0x72D0/MASA/Hardware/Kicad_Project/MASA_Rover_1.0/MASA_Rover_1.0.pdf

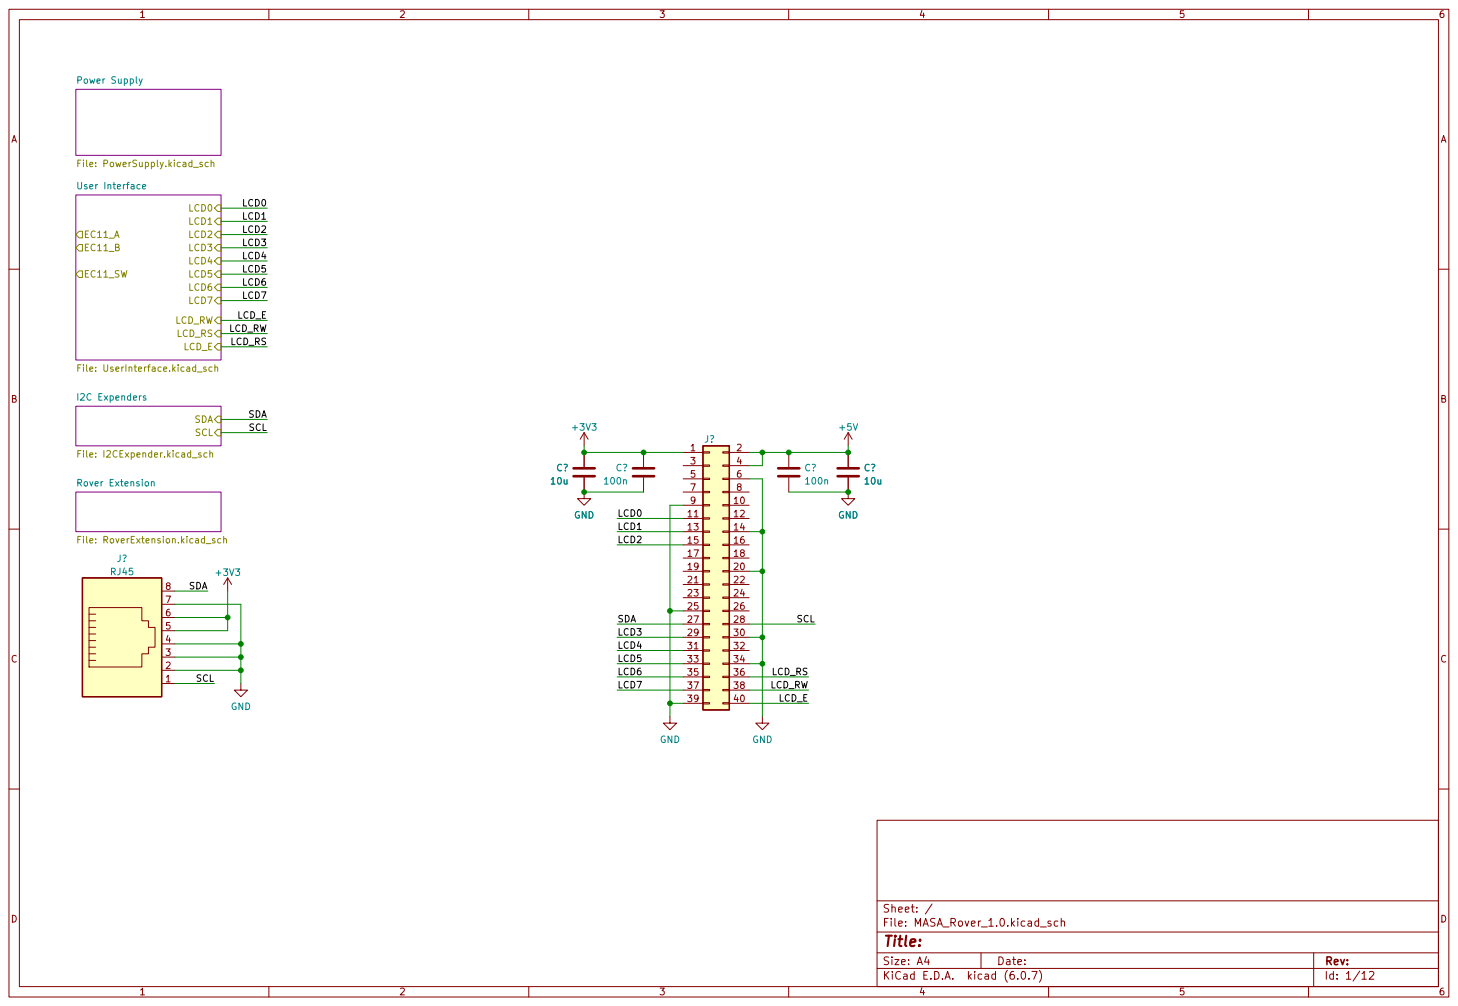
[picture p1: page 1]

User Interface File: UserInterface.kicad_sch Power Supply
File: PowerSupply.kicad_sch Rover Extension File: RoverExtension.kicad_sch SCL SDA

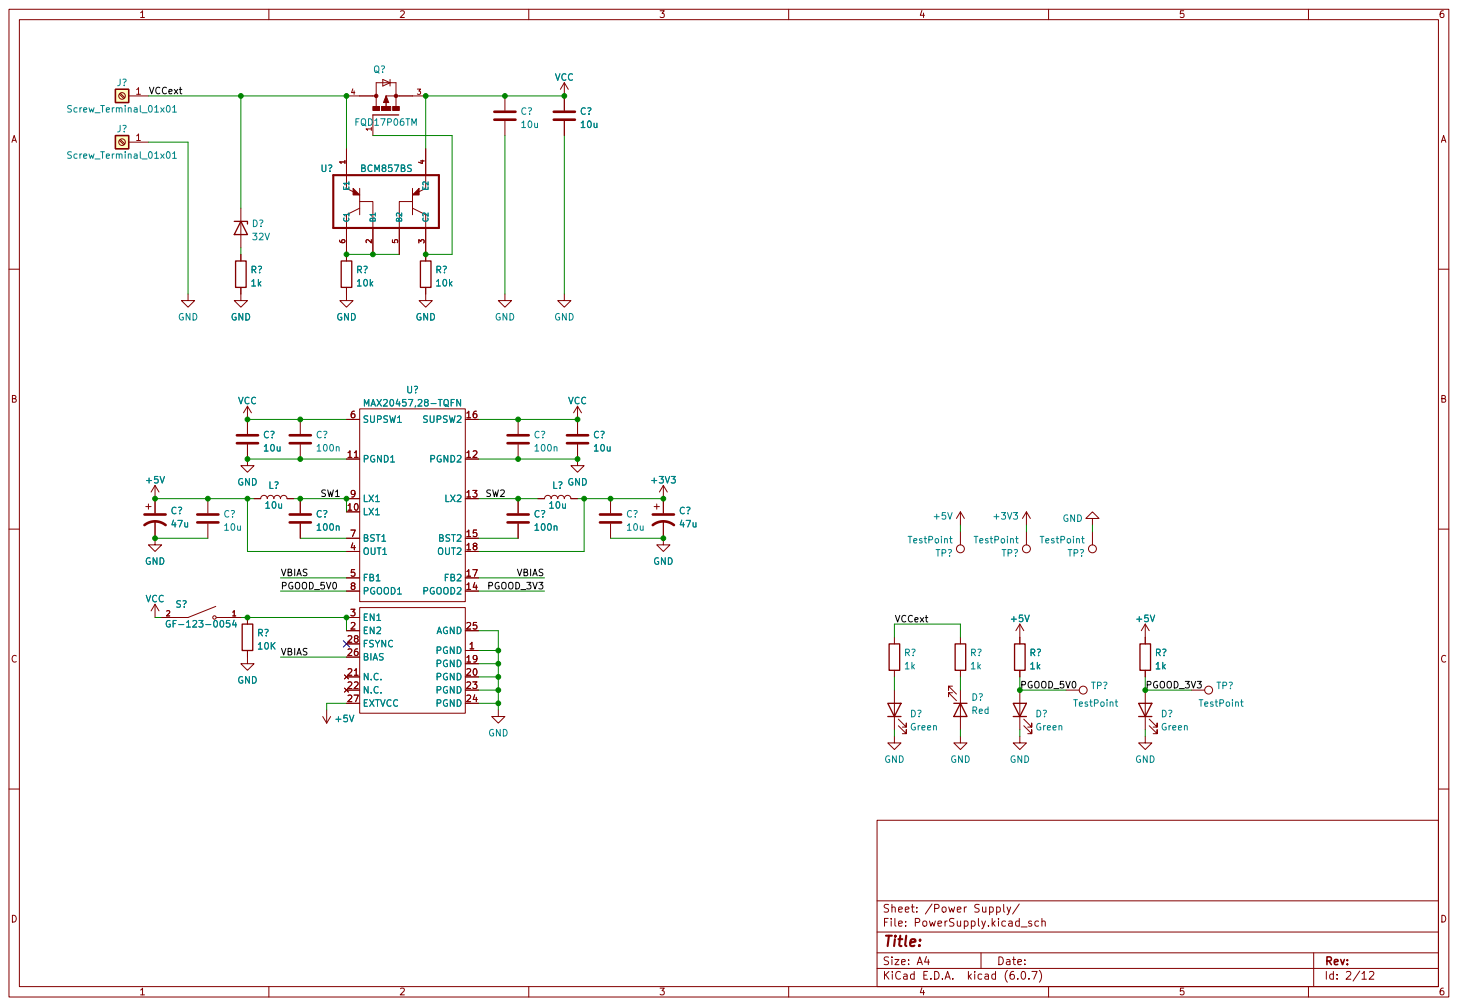
[picture p2: page 2]

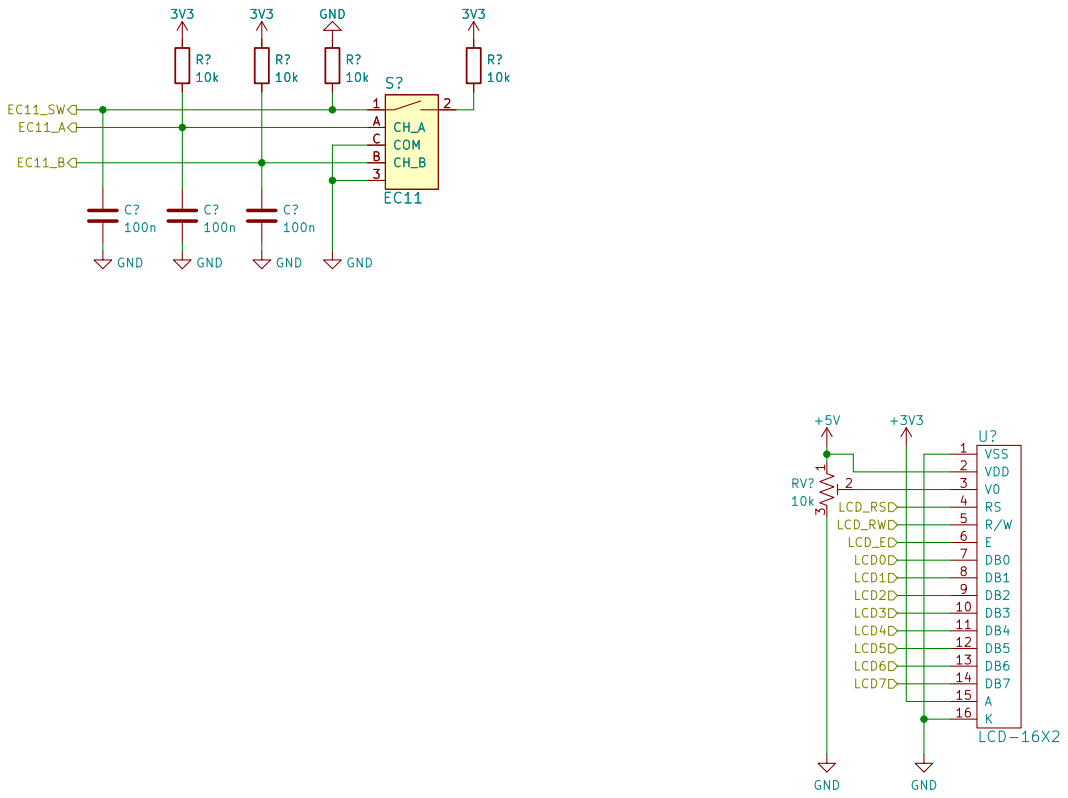
[picture p3: page 3]

File: UserInterface.kicad_sch Sheet: /User Interface/
Id: 3/12 Title:

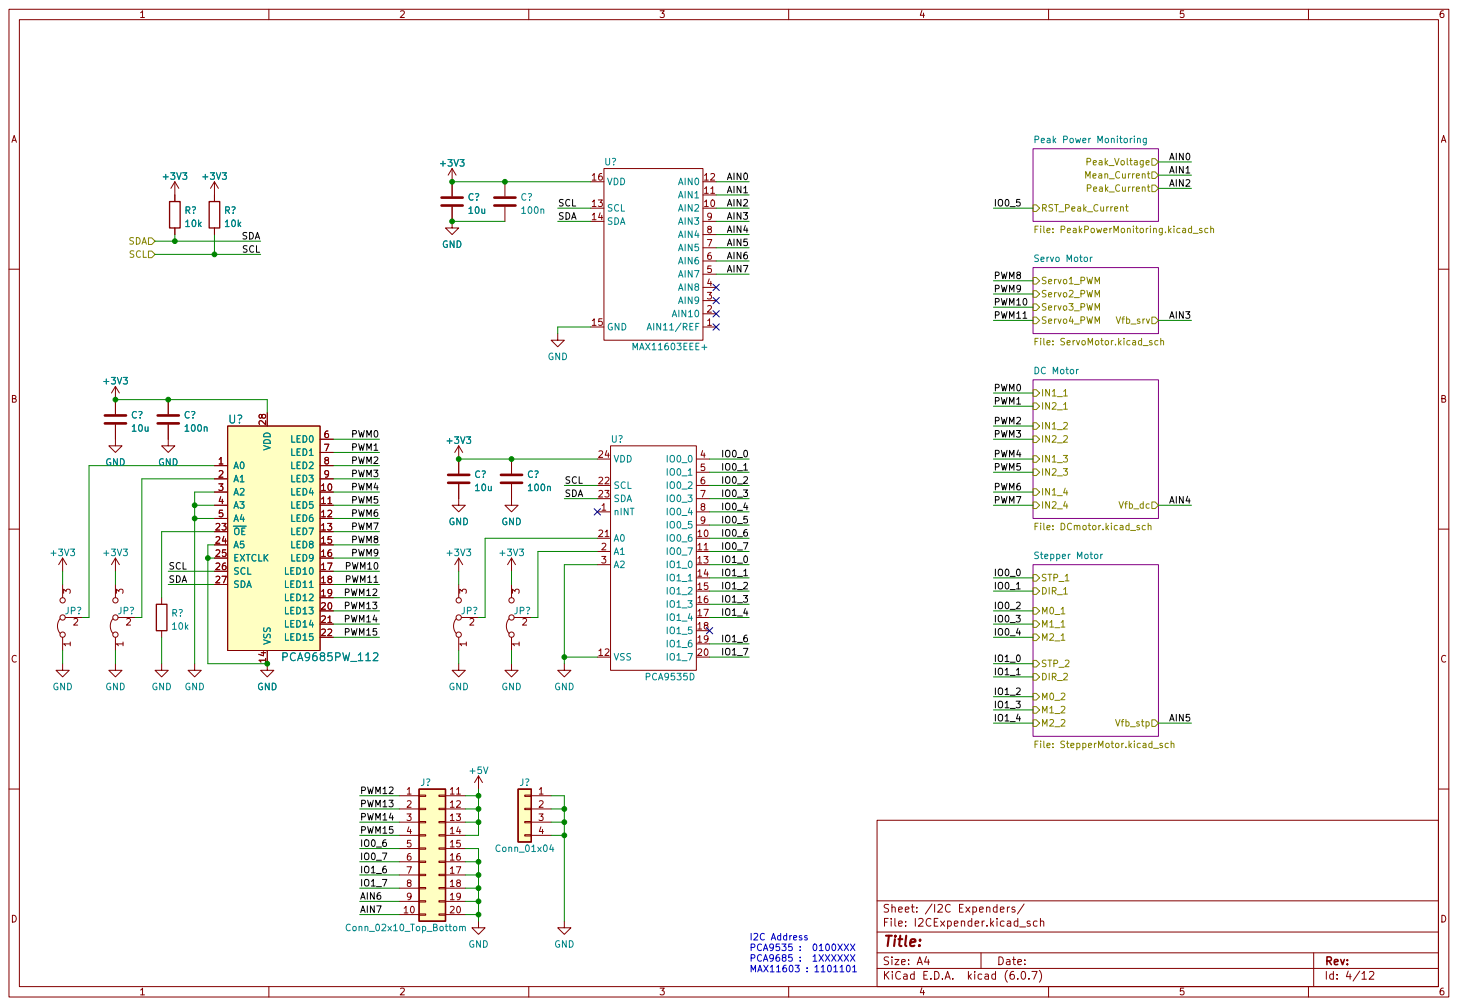
[picture p4: page 4]

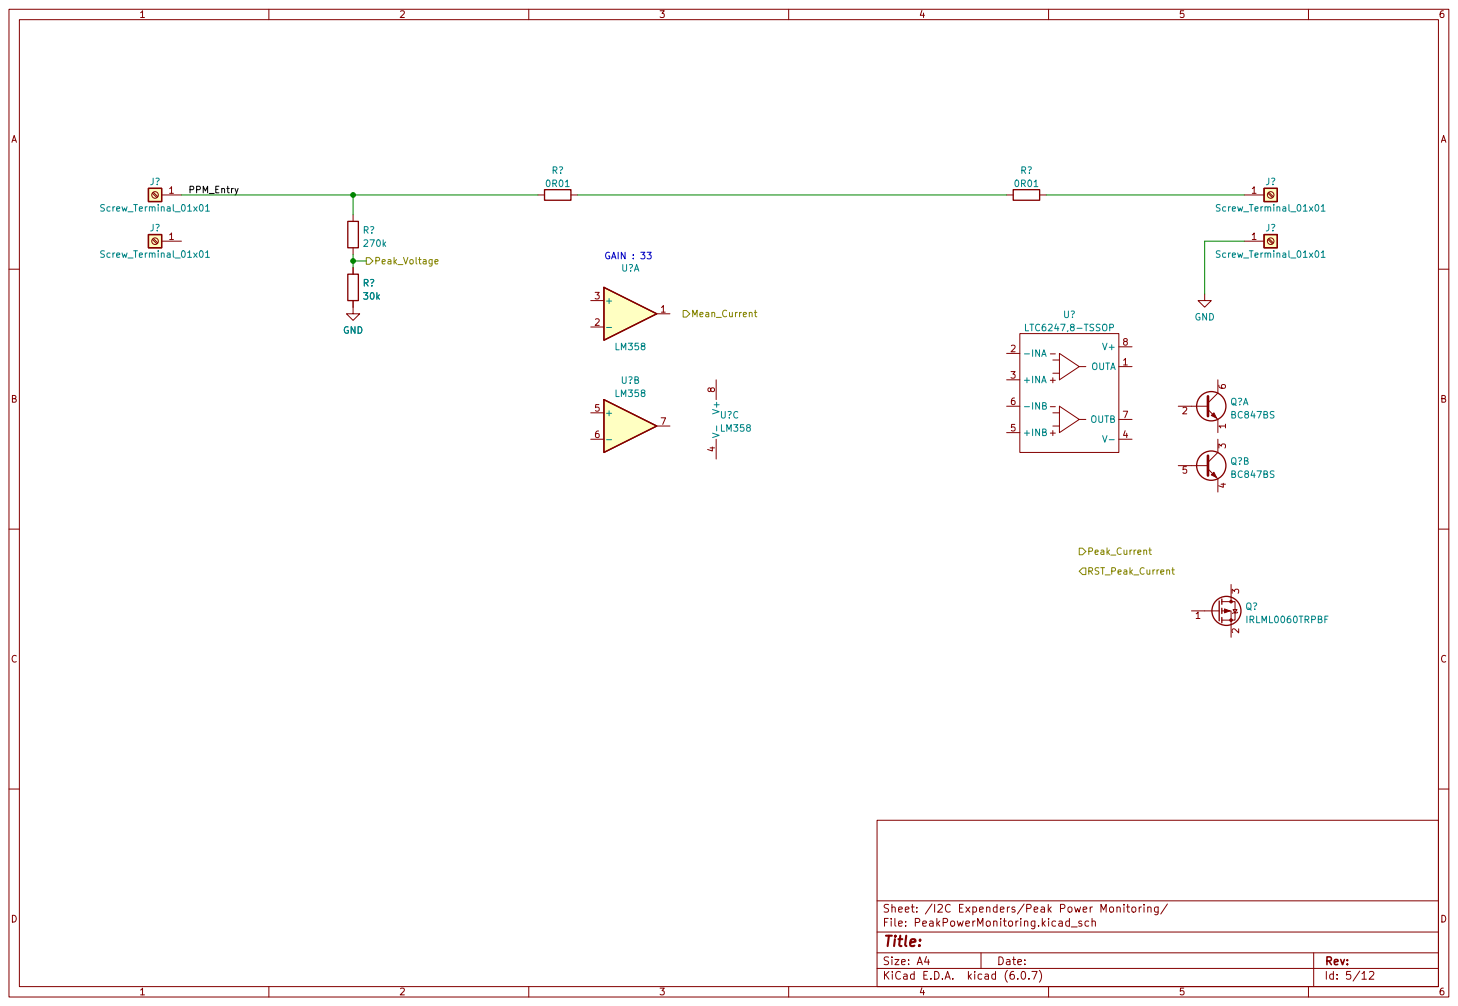
[picture p5: page 5]

Sheet: /I2C Expenders/Peak Power Monitoring/
File: PeakPowerMonitoring.kicad_sch
Id: 5/12 Title:

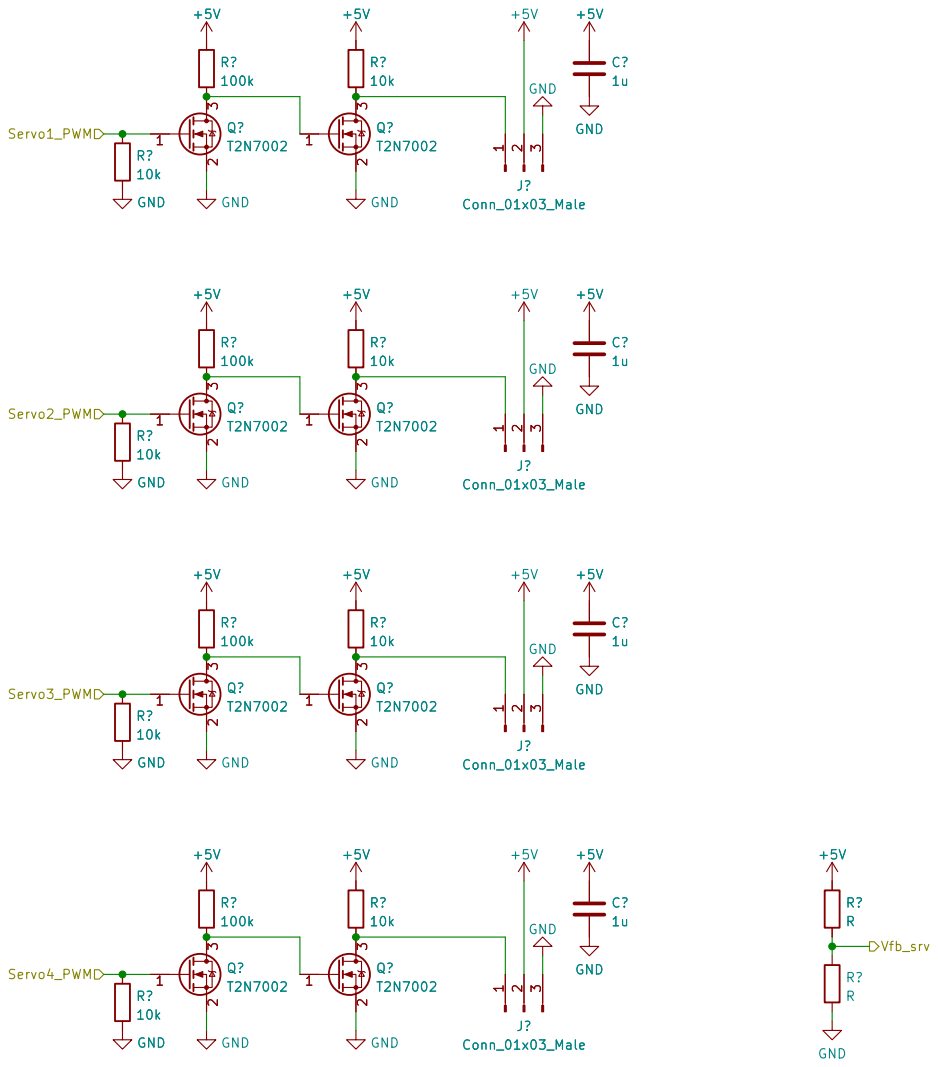
[picture p6: page 6]

Sheet: /I2C Expenders/Servo Motor/ +5V GND

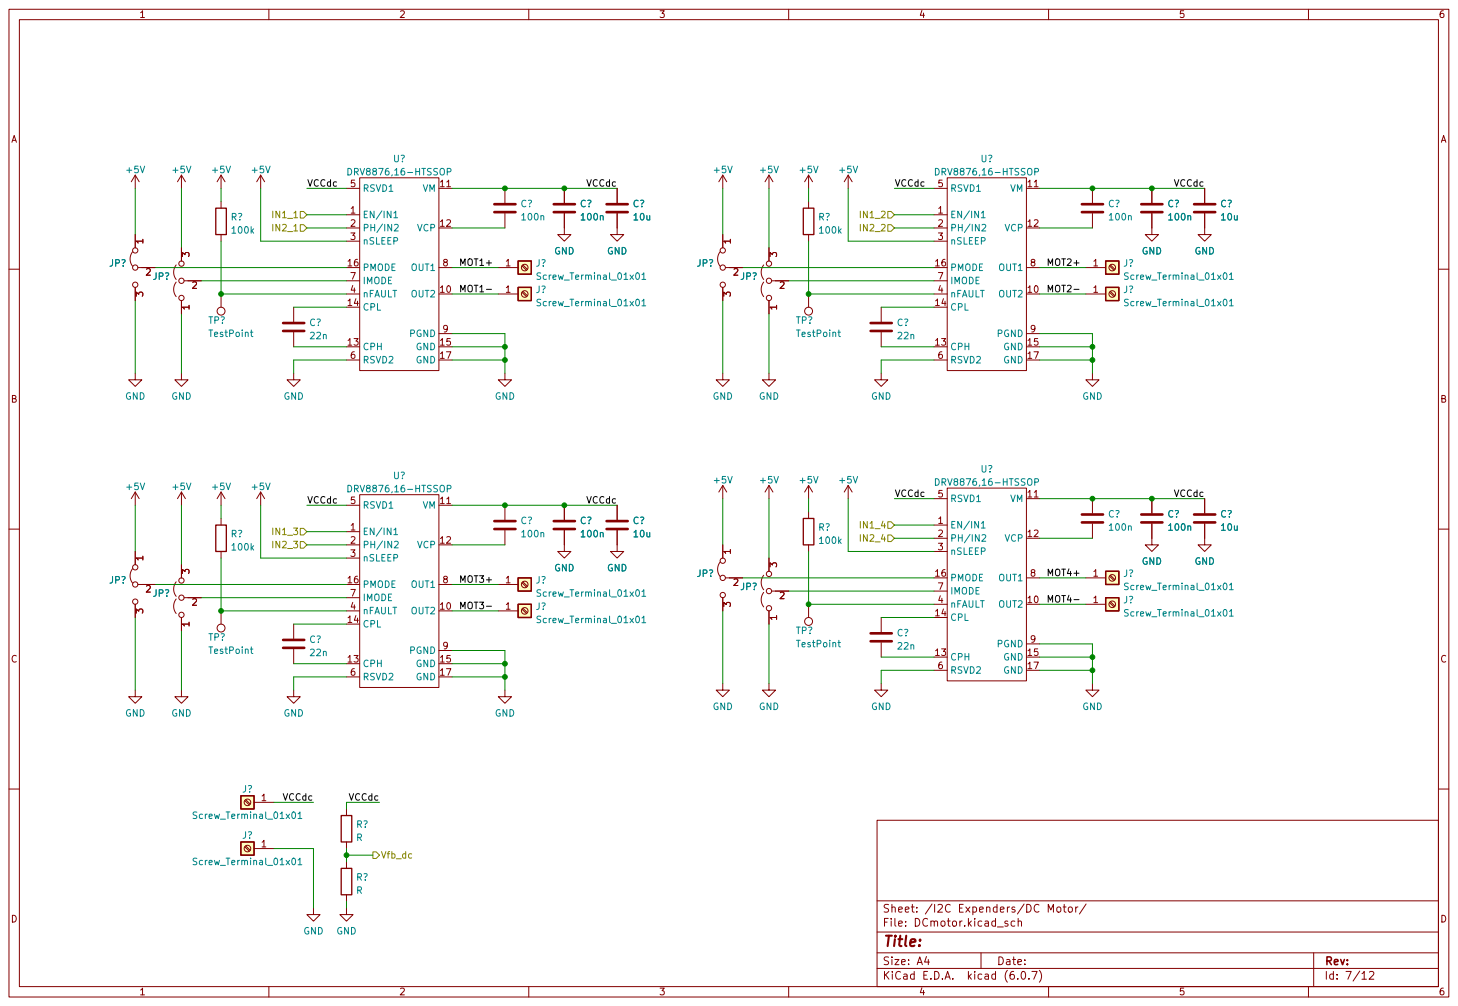
[picture p7: page 7]

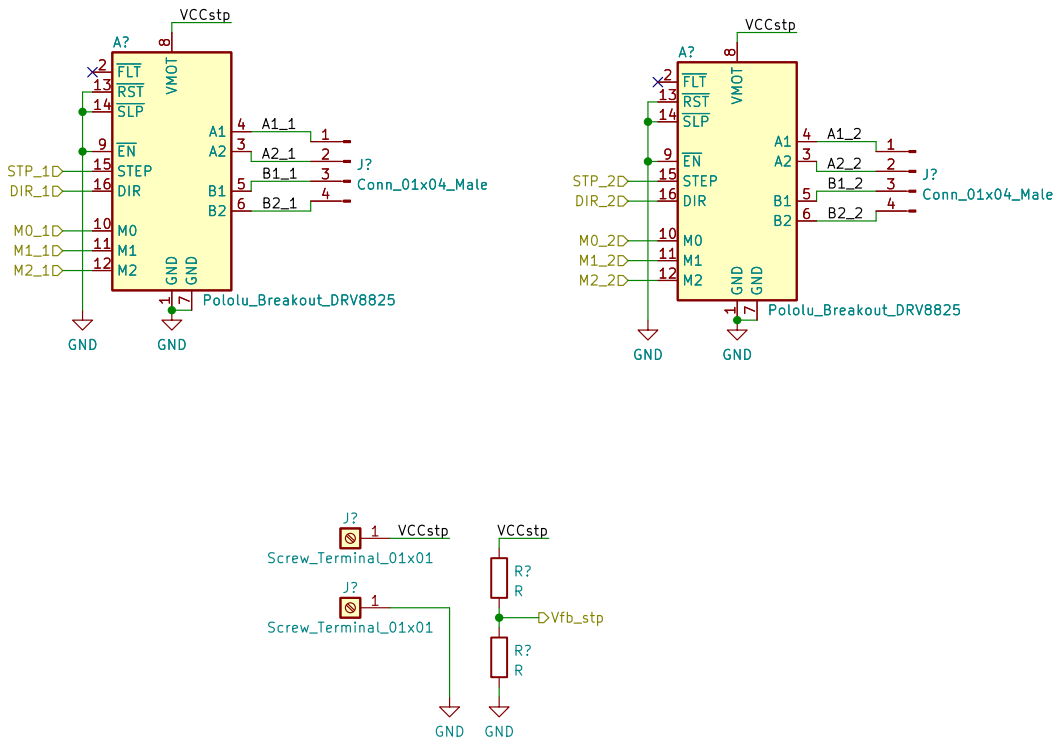
[picture p8: page 8]

8 ~{EN} 9 A? Pololu_Breakout_DRV8825 R? R GND GND GND GND

1 M0 10 M1 11 M2 12 ~{RST} 13 ~{SLP} 14 STEP 15 DIR 16 ~{FLT} 2 A2 3 A1 4 B1 5 B2 6 GND

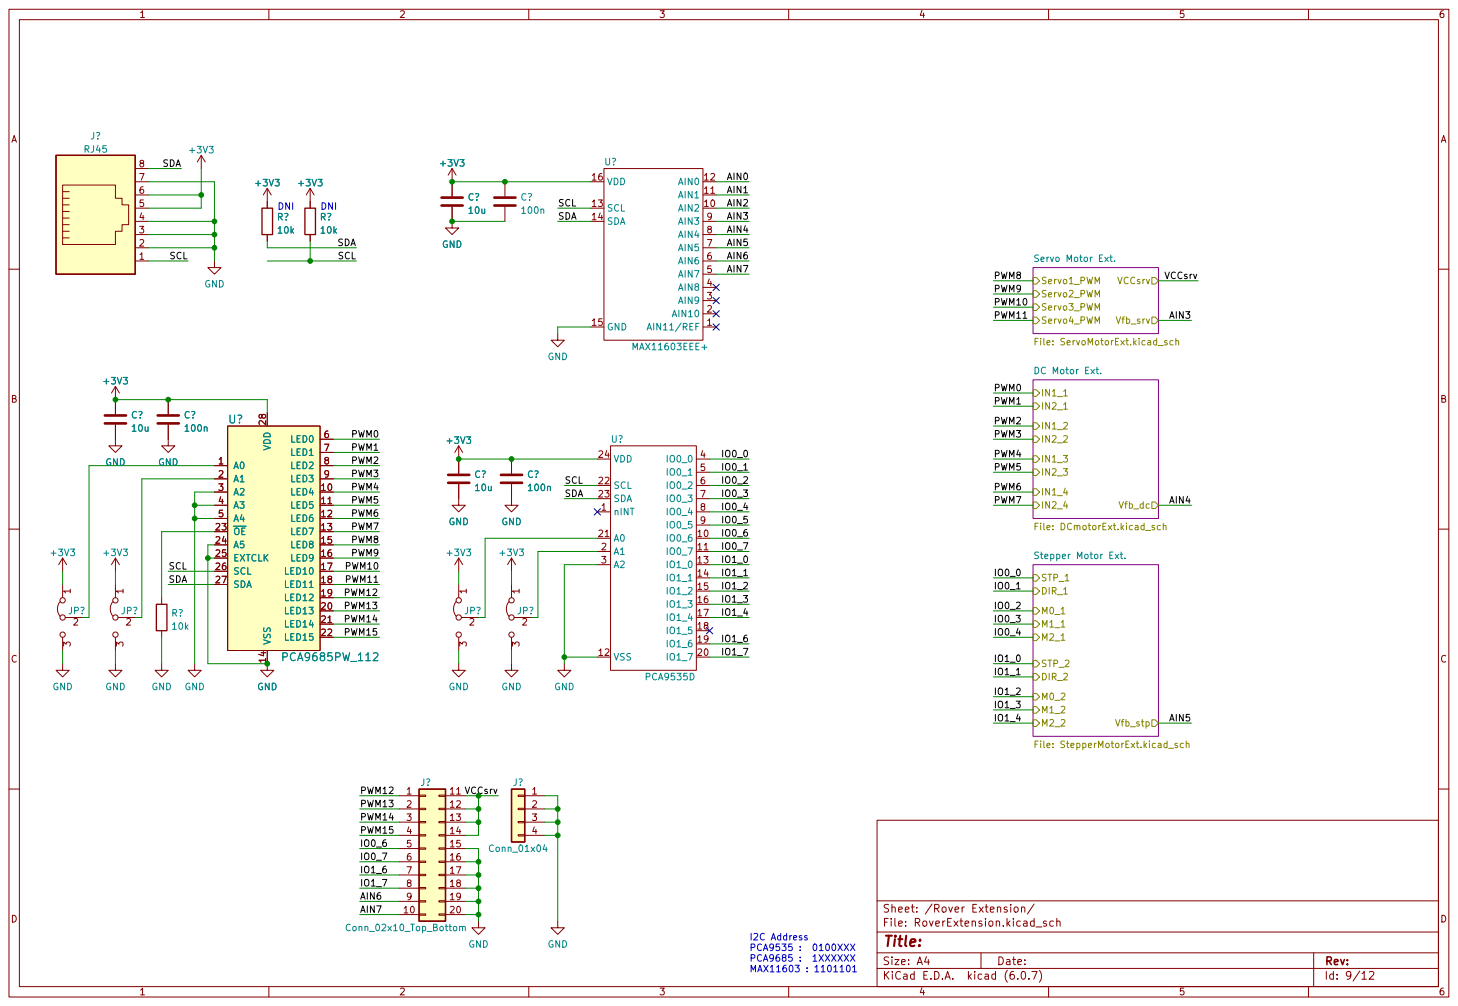
[picture p9: page 9]

3 JP? GND GND GND GND

File: RoverExtension.kicad_sch Sheet: /Rover Extension/
Id: 9/12 Title:

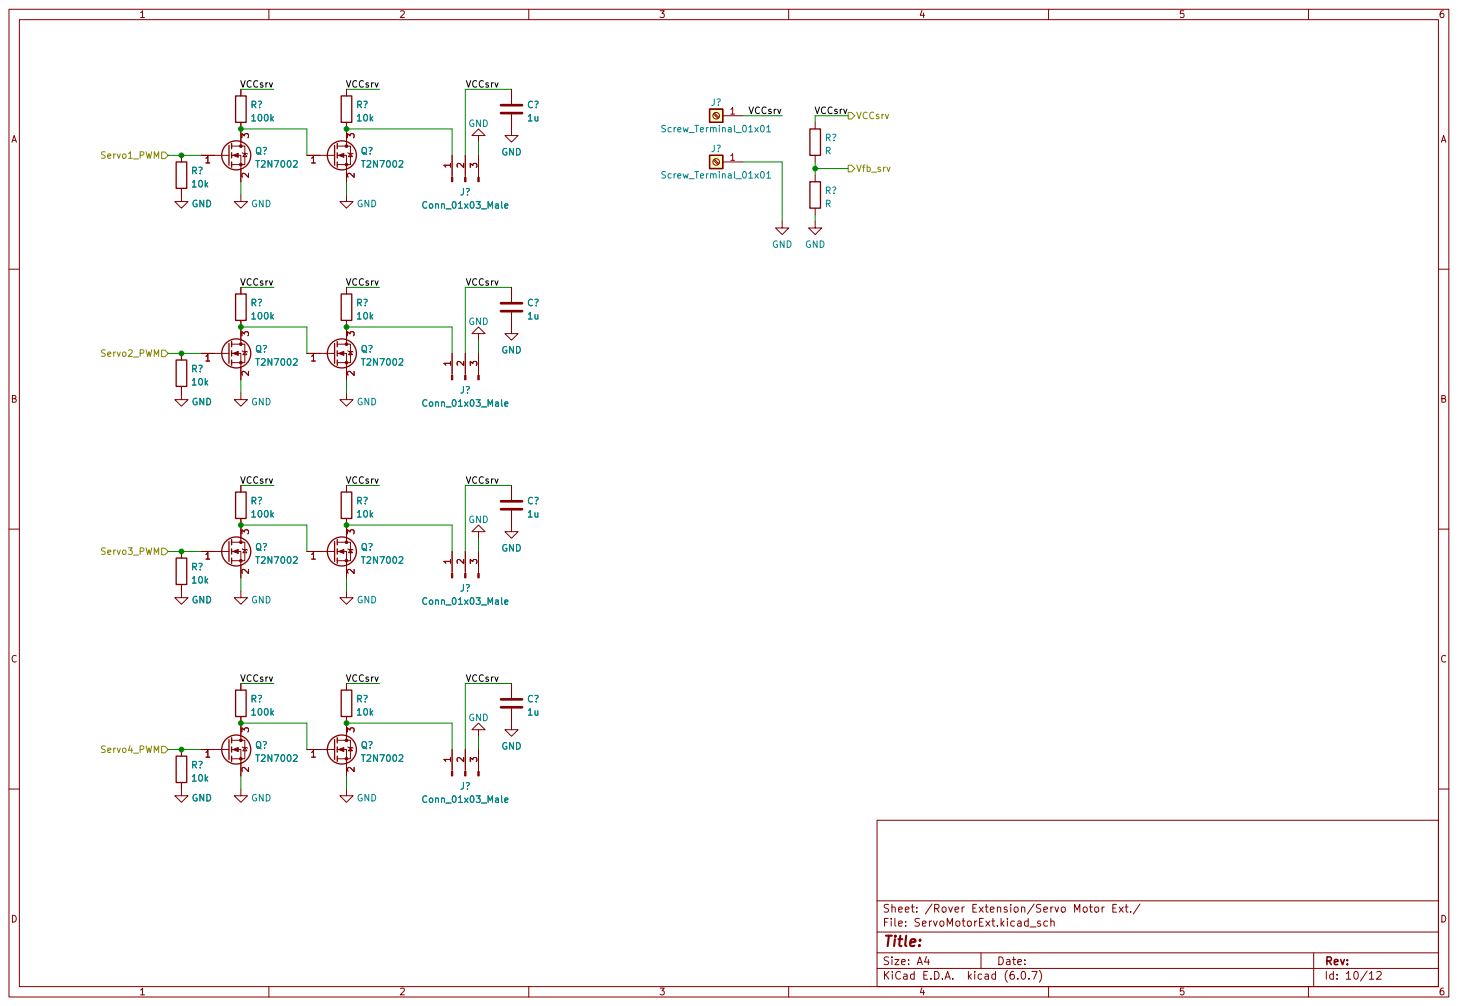
[picture p10: page 10]

File: ServoMotorExt.kicad_sch Sheet: /Rover Extension/Servo Motor Ext./
Id: 10/12 Title:

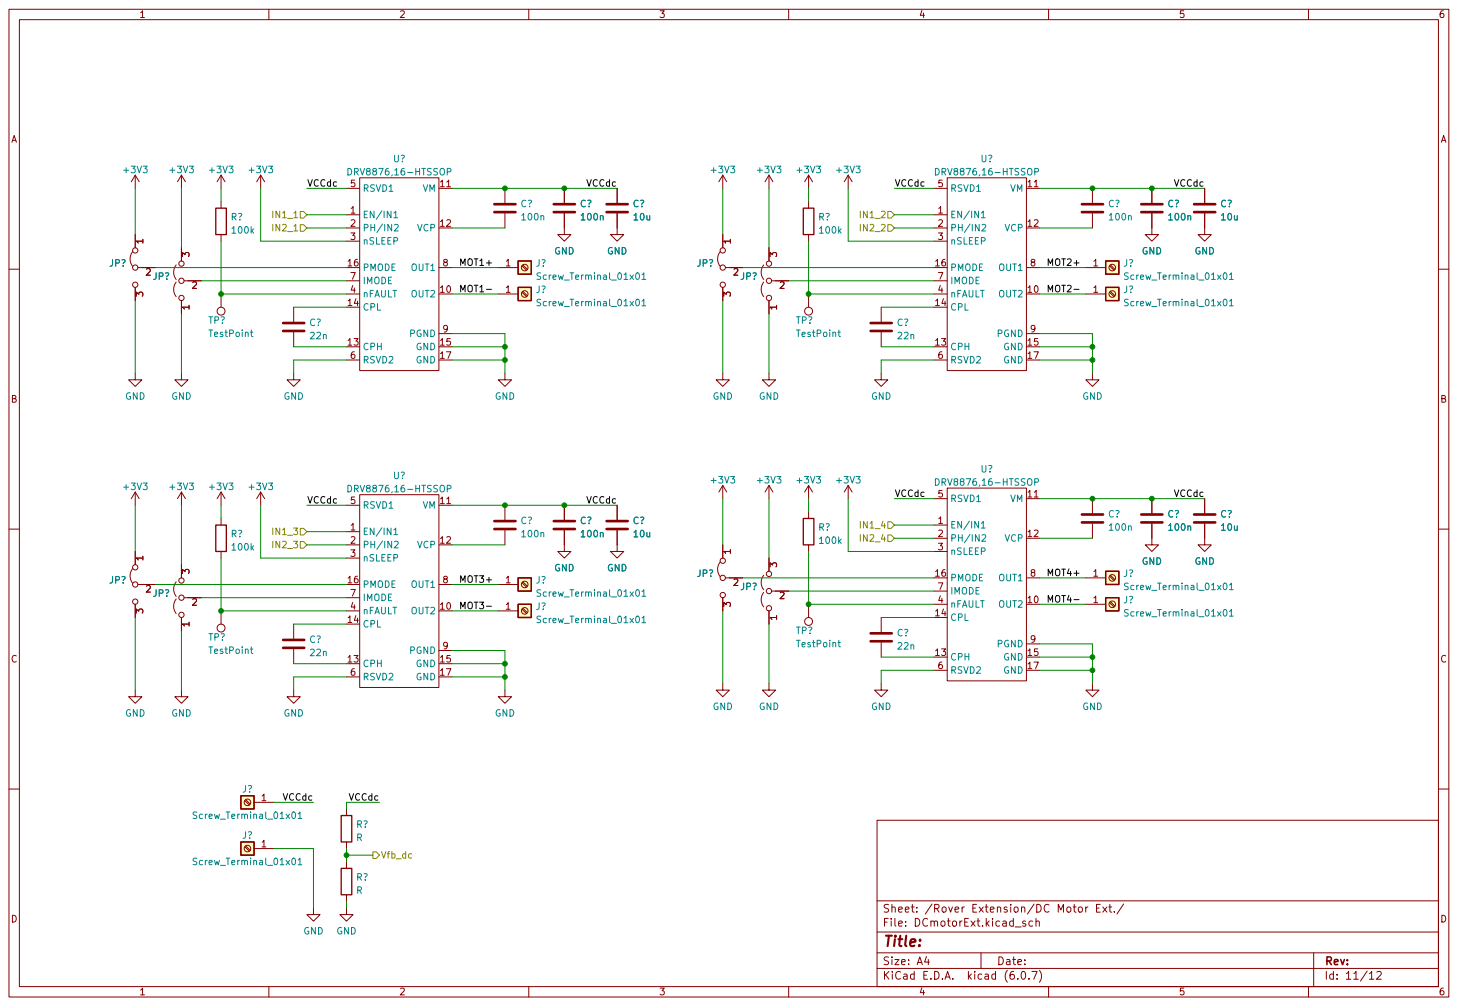
[picture p11: page 11]
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
