0x72D0/MASA/Hardware/Kicad_Project/MASA_Rover_1.0/MASA_Rover_1.0.kicad_pcb

## KiCad design Hardware/Kicad_Project/MASA_Rover_1.0/MASA_Rover_1.0.kicad_pcb (2022-11-12)

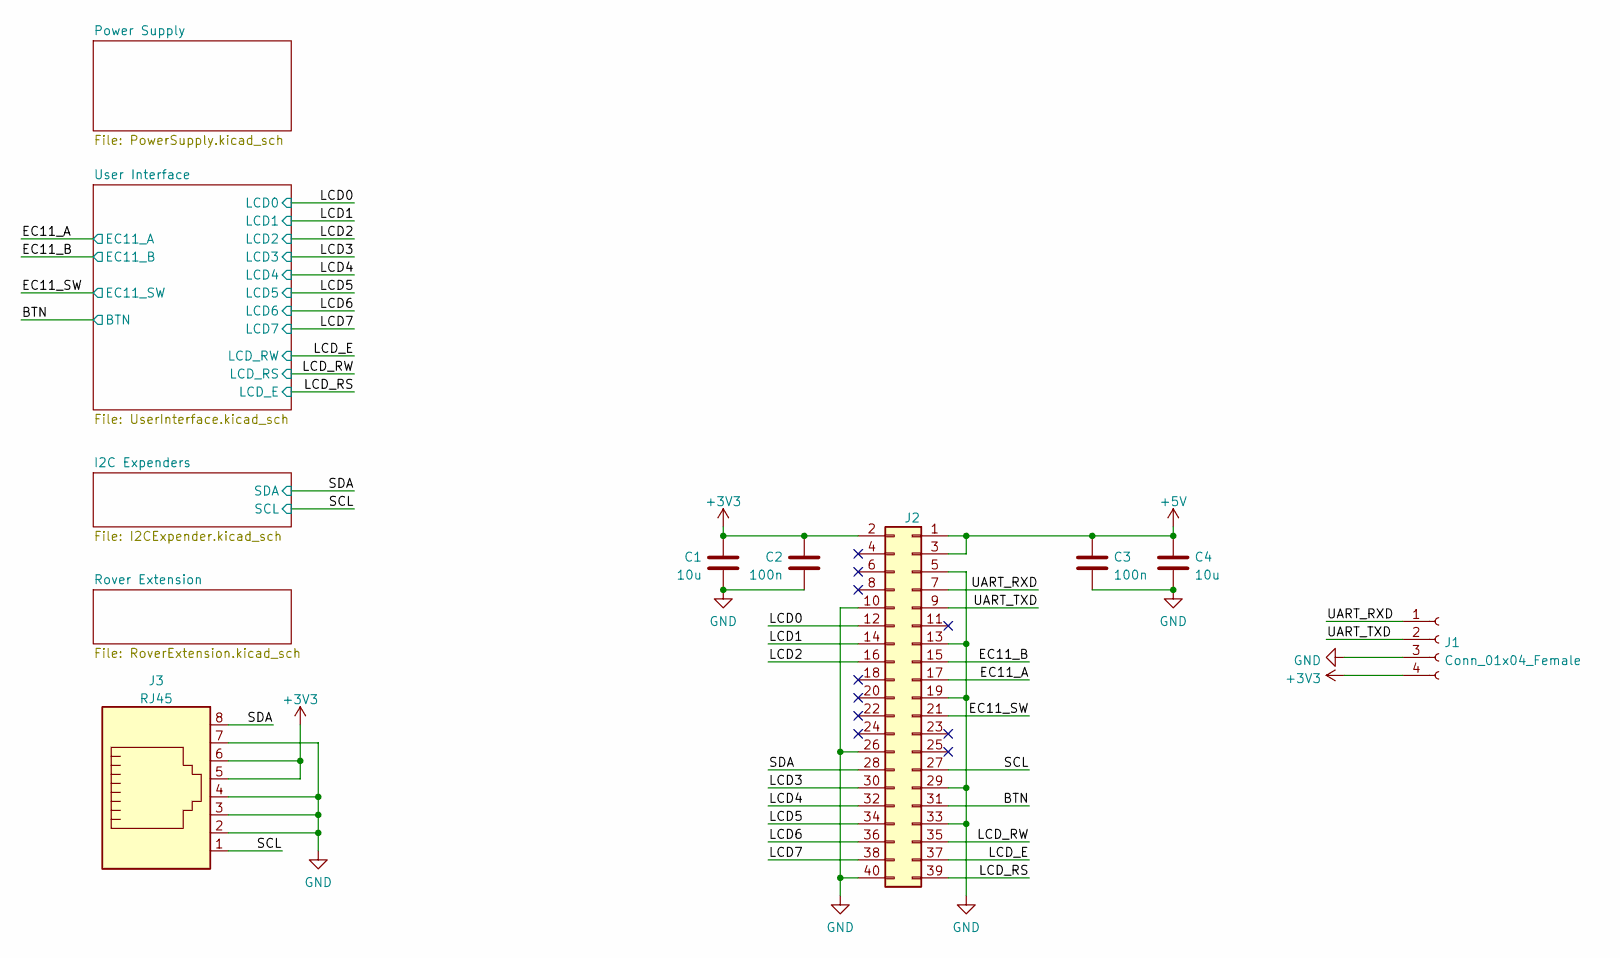
[picture p12: schematic MASA_Rover_1.0.kicad_sch]

Parts:
C1, C4: 10u; C_0805_2012Metric_Pad1.18x1.45mm_HandSolder
C2, C3: 100n; C_0805_2012Metric_Pad1.18x1.45mm_HandSolder
J1: Conn_01x04_Female; PinHeader_1x04_P2.54mm_Vertical
J2: Conn_02x20_Odd_Even; PinHeader_2x20_P2.54mm_Vertical
J3: RJ45; RJ45_Amphenol_54602-x08_Horizontal

Connections:
+3V3: C1.1, C2.1, J1.4, J2.2, J3.5, J3.6; also elsewhere on the board
+5V: C3.1, C4.1, J2.1, J2.3; also elsewhere on the board
/BTN: J2.31; also elsewhere on the board
/EC11_A: J2.17; also elsewhere on the board
/EC11_B: J2.15; also elsewhere on the board
/EC11_SW: J2.21; also elsewhere on the board
/LCD0: J2.12; also elsewhere on the board
/LCD1: J2.14; also elsewhere on the board
/LCD2: J2.16; also elsewhere on the board
/LCD3: J2.30; also elsewhere on the board
/LCD4: J2.32; also elsewhere on the board
/LCD5: J2.34; also elsewhere on the board
/LCD6: J2.36; also elsewhere on the board
/LCD7: J2.38; also elsewhere on the board
/LCD_E: J2.37; also elsewhere on the board
/LCD_RS: J2.39; also elsewhere on the board
/LCD_RW: J2.35; also elsewhere on the board
/SCL: J2.27, J3.1; also elsewhere on the board
/SDA: J2.28, J3.8; also elsewhere on the board
/UART_RXD: J1.1, J2.7
/UART_TXD: J1.2, J2.9
GND: C1.2, C2.2, C3.2, C4.2, J1.3, J2.5, J2.10, J2.13, J2.19, J2.26, J2.29, J2.33, J2.40, J3.2, J3.3, J3.4, J3.7; also elsewhere on the board

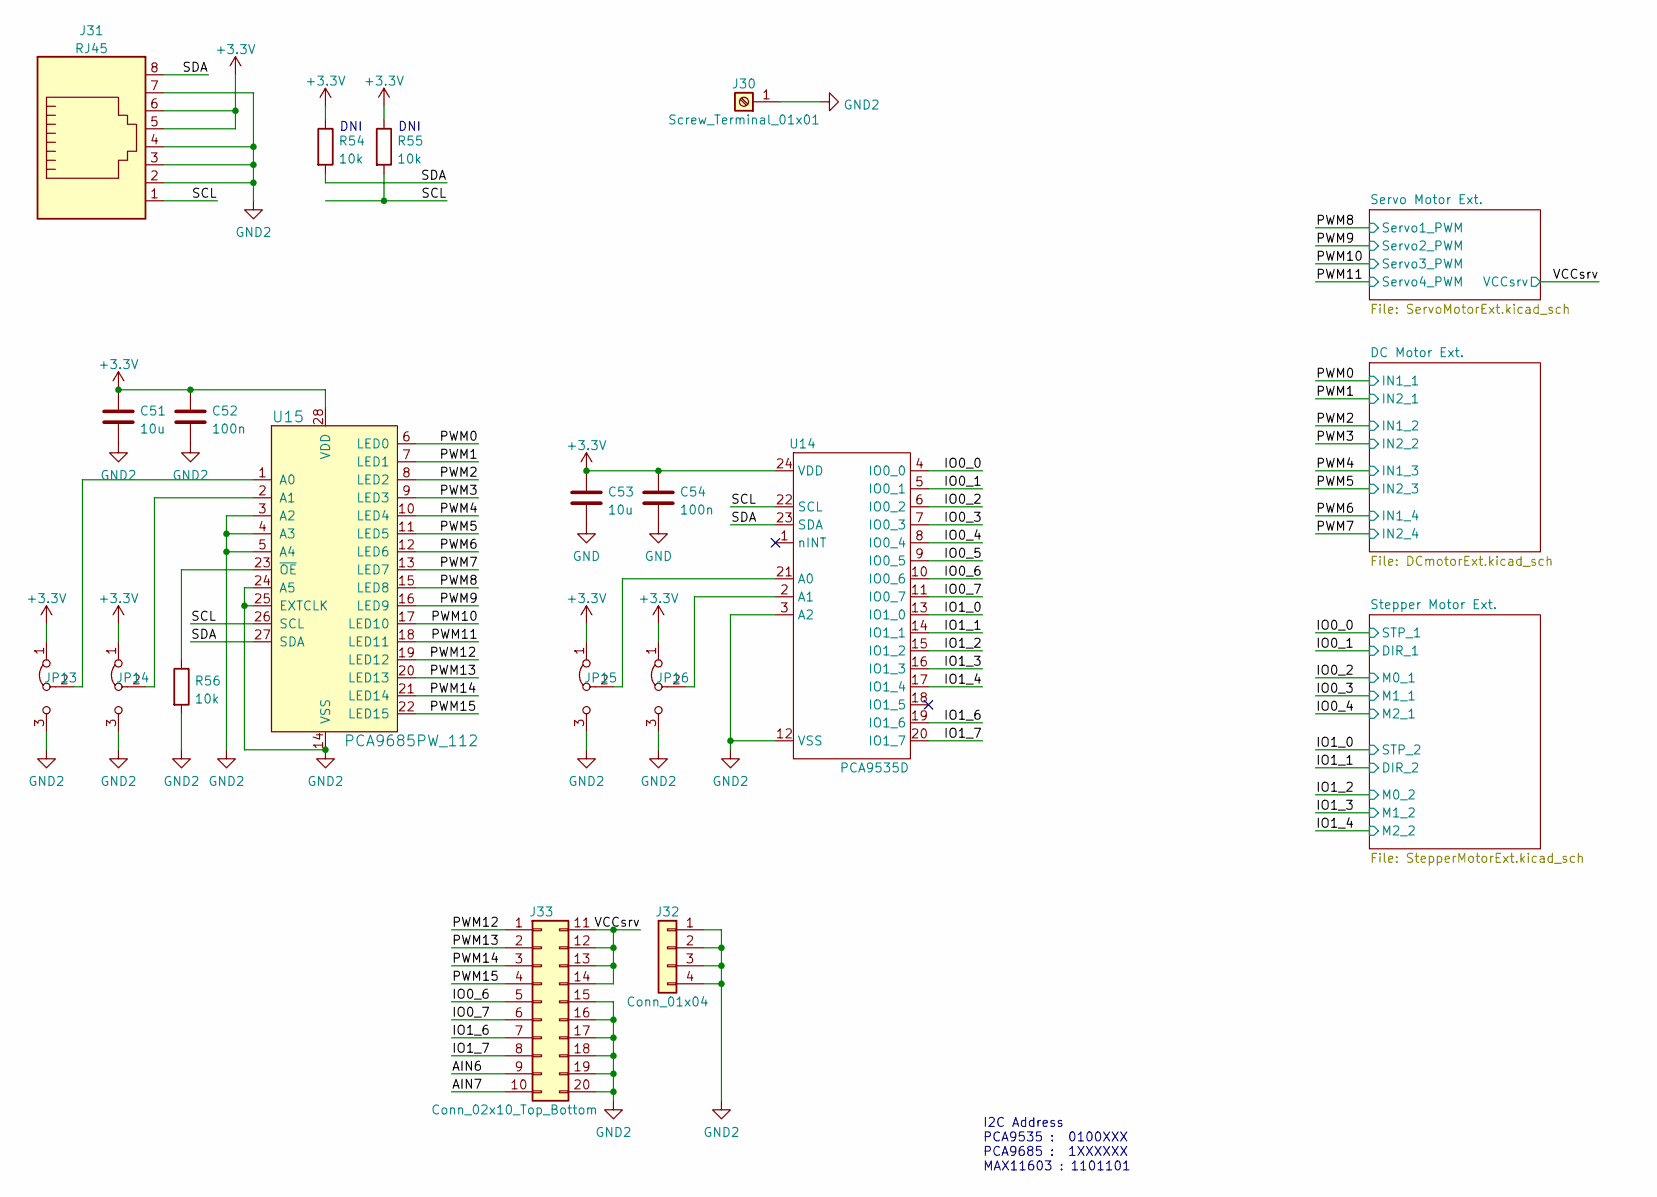
[picture p13: schematic RoverExtension.kicad_sch]

Parts:
C51, C53: 10u; C_0805_2012Metric_Pad1.18x1.45mm_HandSolder
C52, C54: 100n; C_0805_2012Metric_Pad1.18x1.45mm_HandSolder
J30: Screw_Terminal_01x01; ScrewTerminal_1x01_5x7mm
J31: RJ45; RJ45_Amphenol_54602-x08_Horizontal
J32: Conn_01x04; PinHeader_1x04_P2.54mm_Vertical
J33: Conn_02x10_Top_Bottom; PinHeader_2x10_P2.54mm_Vertical
JP13, JP14, JP15, JP16: Jumper_3_Bridged12; SolderJumper-3_P1.3mm_Bridged12_Pad1.0x1.5mm
R54, R55, R56: 10k; R_0805_2012Metric_Pad1.20x1.40mm_HandSolder
U14: PCA9535D; SOIC-24W_7.5x15.4mm_P1.27mm
U15: PCA9685PW_112; TSSOP-28_4.4x9.7mm_P0.65mm; MPN PCA9685PW,112; Digi-Key_PN 568-8366-5-ND

Connections:
+3.3V: C51.1, C52.1, C53.1, C54.1, J31.5, J31.6, JP13.1 (A), JP14.1 (A), JP15.1 (A), JP16.1 (A), R54.1, R55.1, U14.24 (VDD), U15.28 (VDD); also elsewhere on the board
/Rover Extension/AIN6: J33.9
/Rover Extension/AIN7: J33.10
/Rover Extension/IO0_0: U14.4 (IO0_0); also elsewhere on the board
/Rover Extension/IO0_1: U14.5 (IO0_1); also elsewhere on the board
/Rover Extension/IO0_2: U14.6 (IO0_2); also elsewhere on the board
/Rover Extension/IO0_3: U14.7 (IO0_3); also elsewhere on the board
/Rover Extension/IO0_4: U14.8 (IO0_4); also elsewhere on the board
/Rover Extension/IO0_5: U14.9 (IO0_5)
/Rover Extension/IO0_6: J33.5, U14.10 (IO0_6)
/Rover Extension/IO0_7: J33.6, U14.11 (IO0_7)
/Rover Extension/IO1_0: U14.13 (IO1_0); also elsewhere on the board
/Rover Extension/IO1_1: U14.14 (IO1_1); also elsewhere on the board
/Rover Extension/IO1_2: U14.15 (IO1_2); also elsewhere on the board
/Rover Extension/IO1_3: U14.16 (IO1_3); also elsewhere on the board
/Rover Extension/IO1_4: U14.17 (IO1_4); also elsewhere on the board
/Rover Extension/IO1_6: J33.7, U14.19 (IO1_6)
/Rover Extension/IO1_7: J33.8, U14.20 (IO1_7)
/Rover Extension/PWM0: U15.6 (LED0); also elsewhere on the board
/Rover Extension/PWM1: U15.7 (LED1); also elsewhere on the board
/Rover Extension/PWM2: U15.8 (LED2); also elsewhere on the board
/Rover Extension/PWM3: U15.9 (LED3); also elsewhere on the board
/Rover Extension/PWM4: U15.10 (LED4); also elsewhere on the board
/Rover Extension/PWM5: U15.11 (LED5); also elsewhere on the board
/Rover Extension/PWM6: U15.12 (LED6); also elsewhere on the board
/Rover Extension/PWM7: U15.13 (LED7); also elsewhere on the board
/Rover Extension/PWM8: U15.15 (LED8); also elsewhere on the board
/Rover Extension/PWM9: U15.16 (LED9); also elsewhere on the board
/Rover Extension/PWM10: U15.17 (LED10); also elsewhere on the board
/Rover Extension/PWM11: U15.18 (LED11); also elsewhere on the board
/Rover Extension/PWM12: J33.1, U15.19 (LED12)
/Rover Extension/PWM13: J33.2, U15.20 (LED13)
/Rover Extension/PWM14: J33.3, U15.21 (LED14)
/Rover Extension/PWM15: J33.4, U15.22 (LED15)
/Rover Extension/SCL: J31.1, R55.2, U14.22 (SCL), U15.26 (SCL)
/Rover Extension/SDA: J31.8, R54.2, U14.23 (SDA), U15.27 (SDA)
/Rover Extension/VCCsrv: J33.11, J33.12, J33.13, J33.14; also elsewhere on the board
GND: C53.2, C54.2; also elsewhere on the board
GND2: C51.2, C52.2, J30.1, J31.2, J31.3, J31.4, J31.7, J32.1, J32.2, J32.3, J32.4, J33.15, J33.16, J33.17, J33.18, J33.19, J33.20, JP13.3 (B), JP14.3 (B), JP15.3 (B), JP16.3 (B), R56.2, U14.3 (A2), U14.12 (VSS), U15.3 (A2), U15.4 (A3), U15.5 (A4), U15.14 (VSS), U15.24 (A5), U15.25 (EXTCLK); also elsewhere on the board
unnamed: JP13.2 (C), U15.1 (A0)
unnamed: JP14.2 (C), U15.2 (A1)
unnamed: JP15.2 (C), U14.21 (A0)
unnamed: JP16.2 (C), U14.2 (A1)
unnamed: R56.1, U15.23 (~OE)

Notes on the sheet:
DNI
I2C Address PCA9535 : 0100XXX PCA9685 : 1XXXXXX MAX11603 : 1101101

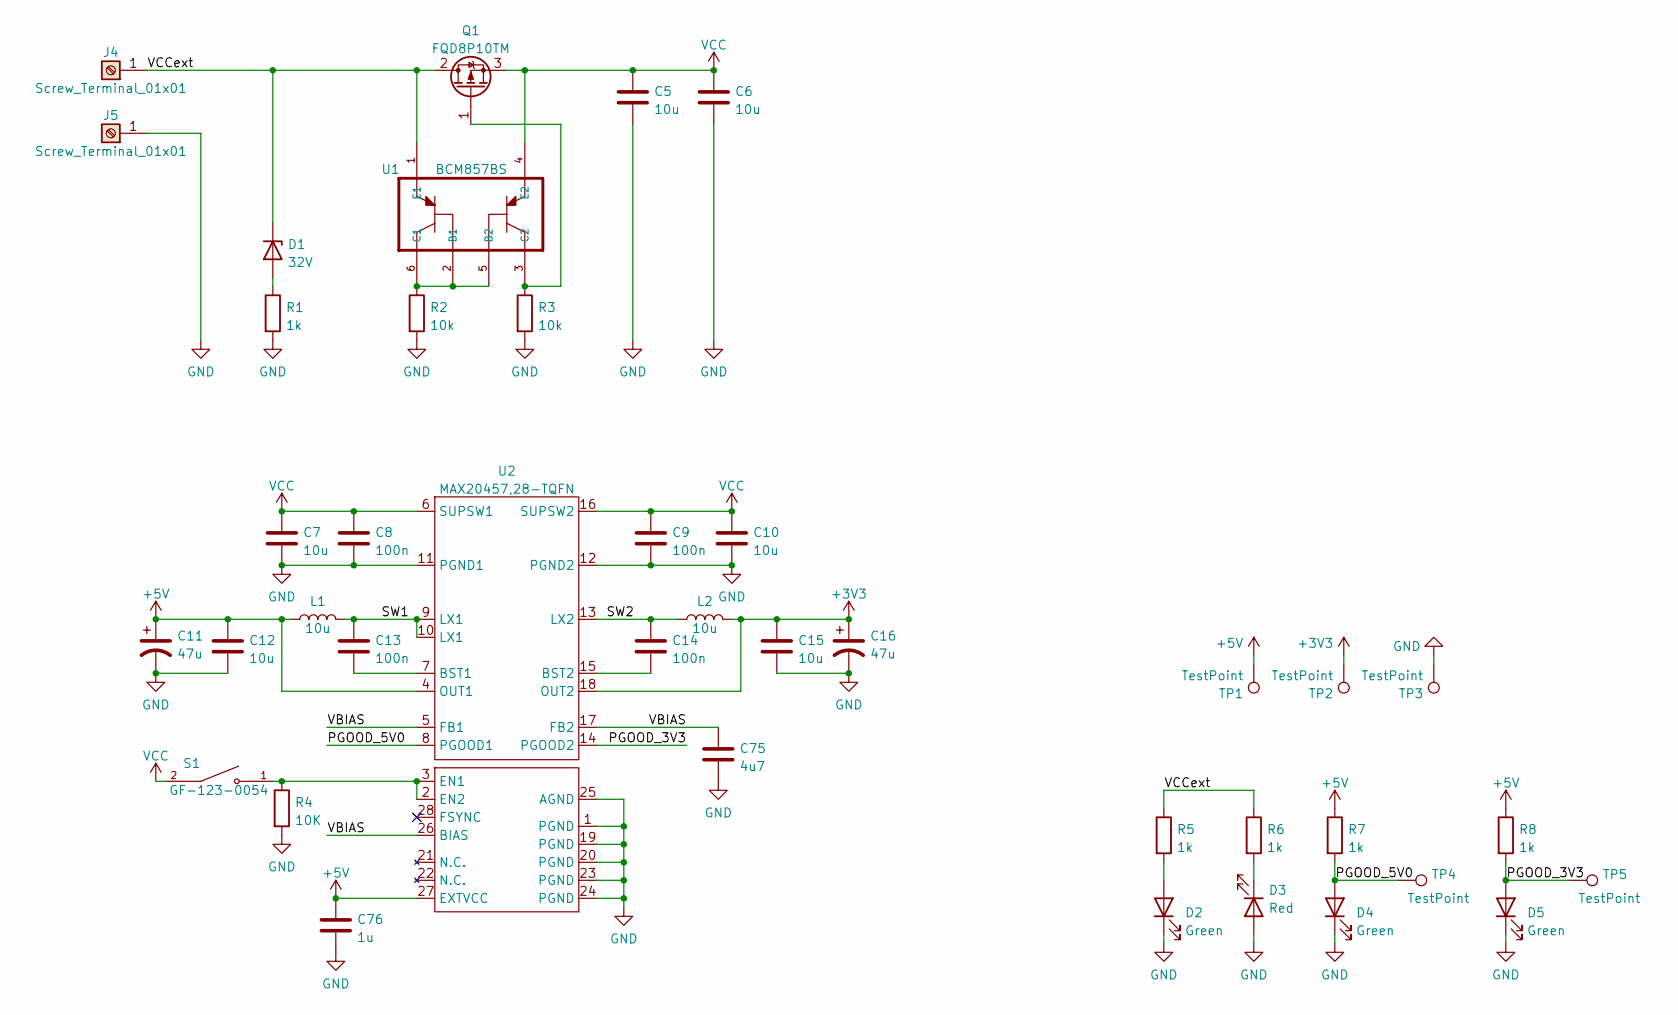
[picture p14: schematic PowerSupply.kicad_sch]

Parts:
C5, C6, C7, C10, C12, C15: 10u; C_0805_2012Metric_Pad1.18x1.45mm_HandSolder
C8, C9, C13, C14: 100n; C_0805_2012Metric_Pad1.18x1.45mm_HandSolder
C11, C16: 47u; C_Elec_6.3x5.8
C75: 4u7; C_0805_2012Metric_Pad1.18x1.45mm_HandSolder
C76: 1u; C_0805_2012Metric_Pad1.18x1.45mm_HandSolder
D1: 32V; C_0805_2012Metric_Pad1.18x1.45mm_HandSolder
D2, D4, D5: Green; D_0805_2012Metric_Pad1.15x1.40mm_HandSolder
D3: Red; D_0805_2012Metric_Pad1.15x1.40mm_HandSolder
J4, J5: Screw_Terminal_01x01; ScrewTerminal_1x01_5x7mm
L1: 10u; L_10.7x10.0mm_H4mm
L2: 10u; L_1210_3225Metric_Pad1.42x2.65mm_HandSolder
Q1: FQD8P10TM; TO-252-2
R1, R5, R6, R7, R8: 1k; R_0805_2012Metric_Pad1.20x1.40mm_HandSolder
R2, R3: 10k; R_0805_2012Metric_Pad1.20x1.40mm_HandSolder
R4: 10K; R_0805_2012Metric_Pad1.20x1.40mm_HandSolder
S1: GF-123-0054; SW_GF-123-0054; PARTREV May 20, 2003
TP1, TP2, TP3, TP4, TP5: TestPoint; TestPoint_Pad_D2.0mm
U1: BCM857BS; SOT-363_SC-70-6_Handsoldering
U2: MAX20457,28-TQFN; TQFN-28-1EP_5x5mm_P0.5mm_EP2.7x2.7mm

Connections:
+3V3: C15.1, C16.1, L2.2, TP2.1, U2.18 (OUT2); also elsewhere on the board
+5V: C11.1, C12.1, C76.1, L1.1, R7.1, R8.1, TP1.1, U2.4 (OUT1), U2.27 (EXTVCC); also elsewhere on the board
/Power Supply/PGOOD_3V3: D5.2 (A), R8.2, TP5.1, U2.14 (PGOOD2)
/Power Supply/PGOOD_5V0: D4.2 (A), R7.2, TP4.1, U2.8 (PGOOD1)
/Power Supply/SW1: C13.2, L1.2, U2.9 (LX1), U2.10 (LX1)
/Power Supply/SW2: C14.2, L2.1, U2.13 (LX2)
/Power Supply/VBIAS: C75.1, U2.5 (FB1), U2.17 (FB2), U2.26 (BIAS)
/Power Supply/VCCext: D1.1 (K), J4.1, Q1.2 (D), R5.1, R6.1, U1.1 (E1)
GND: C5.2, C6.2, C7.2, C8.2, C9.2, C10.2, C11.2, C12.2, C15.2, C16.2, C75.2, C76.2, D2.1 (K), D3.2 (A), D4.1 (K), D5.1 (K), J5.1, R1.2, R2.2, R3.2, R4.2, TP3.1, U2.1 (PGND), U2.11 (PGND1), U2.12 (PGND2), U2.19 (PGND), U2.20 (PGND), U2.23 (PGND), U2.24 (PGND), U2.25 (AGND); also elsewhere on the board
unnamed: C13.1, U2.7 (BST1)
unnamed: C14.1, U2.15 (BST2)
unnamed: D1.2 (A), R1.1
unnamed: D2.2 (A), R5.2
unnamed: D3.1 (K), R6.2
unnamed: Q1.1 (G), R3.1, U1.3 (C2)
unnamed: R2.1, U1.2 (B1), U1.5 (B2), U1.6 (C1)
unnamed: R4.1, S1.1, U2.2 (EN2), U2.3 (EN1)
VCC: C5.1, C6.1, C7.1, C8.1, C9.1, C10.1, Q1.3 (S), S1.2, U1.4 (E2), U2.6 (SUPSW1), U2.16 (SUPSW2)

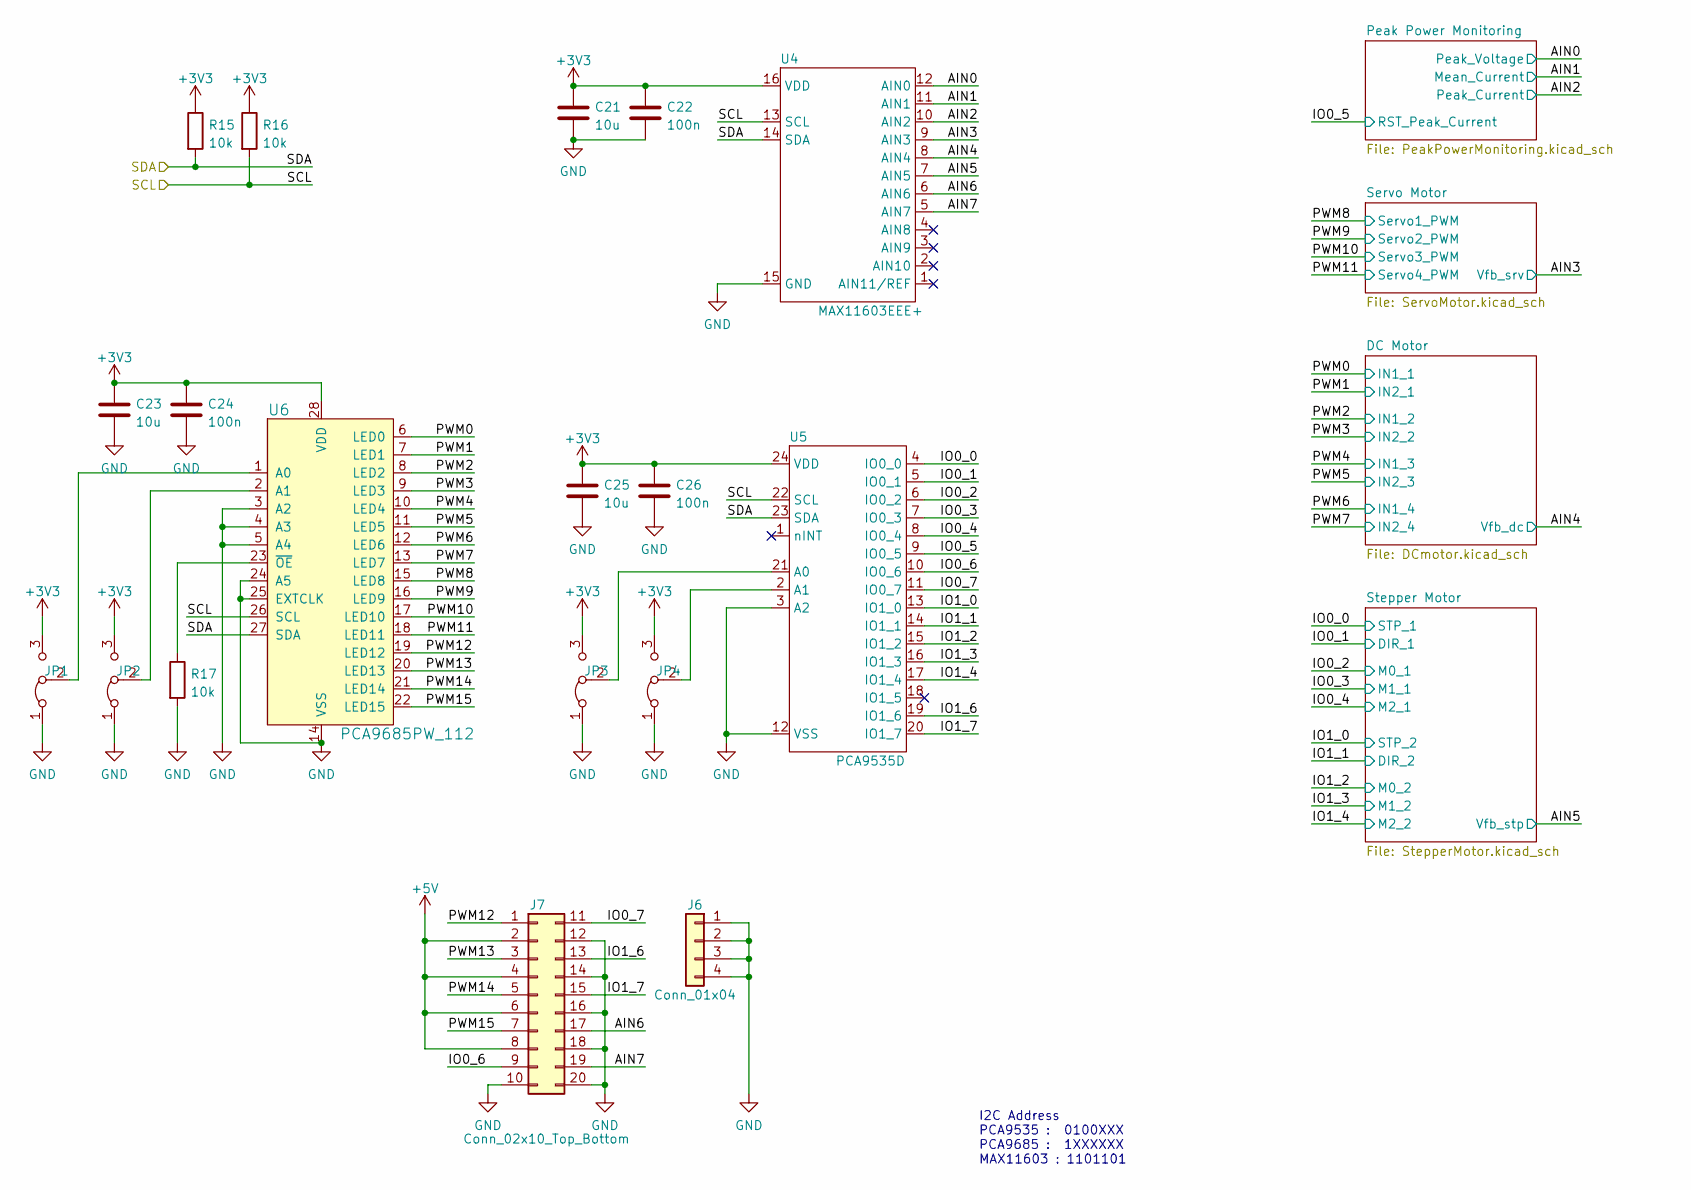
[picture p15: schematic I2CExpender.kicad_sch]

Parts:
C21, C23, C25: 10u; C_0805_2012Metric_Pad1.18x1.45mm_HandSolder
C22, C24, C26: 100n; C_0805_2012Metric_Pad1.18x1.45mm_HandSolder
J6: Conn_01x04; PinHeader_1x04_P2.54mm_Vertical
J7: Conn_02x10_Top_Bottom; PinHeader_2x10_P2.54mm_Vertical
JP1, JP2, JP3, JP4: Jumper_3_Bridged12; SolderJumper-3_P1.3mm_Bridged12_Pad1.0x1.5mm
R15, R16, R17: 10k; R_0805_2012Metric_Pad1.20x1.40mm_HandSolder
U4: MAX11603EEE+; SSOP-16_3.9x4.9mm_P0.635mm
U5: PCA9535D; SOIC-24W_7.5x15.4mm_P1.27mm
U6: PCA9685PW_112; TSSOP-28_4.4x9.7mm_P0.65mm; MPN PCA9685PW,112; Digi-Key_PN 568-8366-5-ND

Connections:
+3V3: C21.1, C22.1, C23.1, C24.1, C25.1, C26.1, JP1.3 (B), JP2.3 (B), JP3.3 (B), JP4.3 (B), R15.1, R16.1, U4.16 (VDD), U5.24 (VDD), U6.28 (VDD); also elsewhere on the board
+5V: J7.2, J7.4, J7.6, J7.8; also elsewhere on the board
/I2C Expenders/AIN0: U4.12 (AIN0); also elsewhere on the board
/I2C Expenders/AIN1: U4.11 (AIN1); also elsewhere on the board
/I2C Expenders/AIN2: U4.10 (AIN2); also elsewhere on the board
/I2C Expenders/AIN3: U4.9 (AIN3); also elsewhere on the board
/I2C Expenders/AIN4: U4.8 (AIN4); also elsewhere on the board
/I2C Expenders/AIN5: U4.7 (AIN5); also elsewhere on the board
/I2C Expenders/AIN6: J7.17, U4.6 (AIN6)
/I2C Expenders/AIN7: J7.19, U4.5 (AIN7)
/I2C Expenders/IO0_0: U5.4 (IO0_0); also elsewhere on the board
/I2C Expenders/IO0_1: U5.5 (IO0_1); also elsewhere on the board
/I2C Expenders/IO0_2: U5.6 (IO0_2); also elsewhere on the board
/I2C Expenders/IO0_3: U5.7 (IO0_3); also elsewhere on the board
/I2C Expenders/IO0_4: U5.8 (IO0_4); also elsewhere on the board
/I2C Expenders/IO0_5: U5.9 (IO0_5); also elsewhere on the board
/I2C Expenders/IO0_6: J7.9, U5.10 (IO0_6)
/I2C Expenders/IO0_7: J7.11, U5.11 (IO0_7)
/I2C Expenders/IO1_0: U5.13 (IO1_0); also elsewhere on the board
/I2C Expenders/IO1_1: U5.14 (IO1_1); also elsewhere on the board
/I2C Expenders/IO1_2: U5.15 (IO1_2); also elsewhere on the board
/I2C Expenders/IO1_3: U5.16 (IO1_3); also elsewhere on the board
/I2C Expenders/IO1_4: U5.17 (IO1_4); also elsewhere on the board
/I2C Expenders/IO1_6: J7.13, U5.19 (IO1_6)
/I2C Expenders/IO1_7: J7.15, U5.20 (IO1_7)
/I2C Expenders/PWM0: U6.6 (LED0); also elsewhere on the board
/I2C Expenders/PWM1: U6.7 (LED1); also elsewhere on the board
/I2C Expenders/PWM2: U6.8 (LED2); also elsewhere on the board
/I2C Expenders/PWM3: U6.9 (LED3); also elsewhere on the board
/I2C Expenders/PWM4: U6.10 (LED4); also elsewhere on the board
/I2C Expenders/PWM5: U6.11 (LED5); also elsewhere on the board
/I2C Expenders/PWM6: U6.12 (LED6); also elsewhere on the board
/I2C Expenders/PWM7: U6.13 (LED7); also elsewhere on the board
/I2C Expenders/PWM8: U6.15 (LED8); also elsewhere on the board
/I2C Expenders/PWM9: U6.16 (LED9); also elsewhere on the board
/I2C Expenders/PWM10: U6.17 (LED10); also elsewhere on the board
/I2C Expenders/PWM11: U6.18 (LED11); also elsewhere on the board
/I2C Expenders/PWM12: J7.1, U6.19 (LED12)
/I2C Expenders/PWM13: J7.3, U6.20 (LED13)
/I2C Expenders/PWM14: J7.5, U6.21 (LED14)
/I2C Expenders/PWM15: J7.7, U6.22 (LED15)
/SCL: R16.2, U4.13 (SCL), U5.22 (SCL), U6.26 (SCL); also elsewhere on the board
/SDA: R15.2, U4.14 (SDA), U5.23 (SDA), U6.27 (SDA); also elsewhere on the board
GND: C21.2, C22.2, C23.2, C24.2, C25.2, C26.2, J6.1, J6.2, J6.3, J6.4, J7.10, J7.12, J7.14, J7.16, J7.18, J7.20, JP1.1 (A), JP2.1 (A), JP3.1 (A), JP4.1 (A), R17.2, U4.15 (GND), U5.3 (A2), U5.12 (VSS), U6.3 (A2), U6.4 (A3), U6.5 (A4), U6.14 (VSS), U6.24 (A5), U6.25 (EXTCLK); also elsewhere on the board
unnamed: JP1.2 (C), U6.1 (A0)
unnamed: JP2.2 (C), U6.2 (A1)
unnamed: JP3.2 (C), U5.21 (A0)
unnamed: JP4.2 (C), U5.2 (A1)
unnamed: R17.1, U6.23 (~OE)

Notes on the sheet:
I2C Address PCA9535 : 0100XXX PCA9685 : 1XXXXXX MAX11603 : 1101101

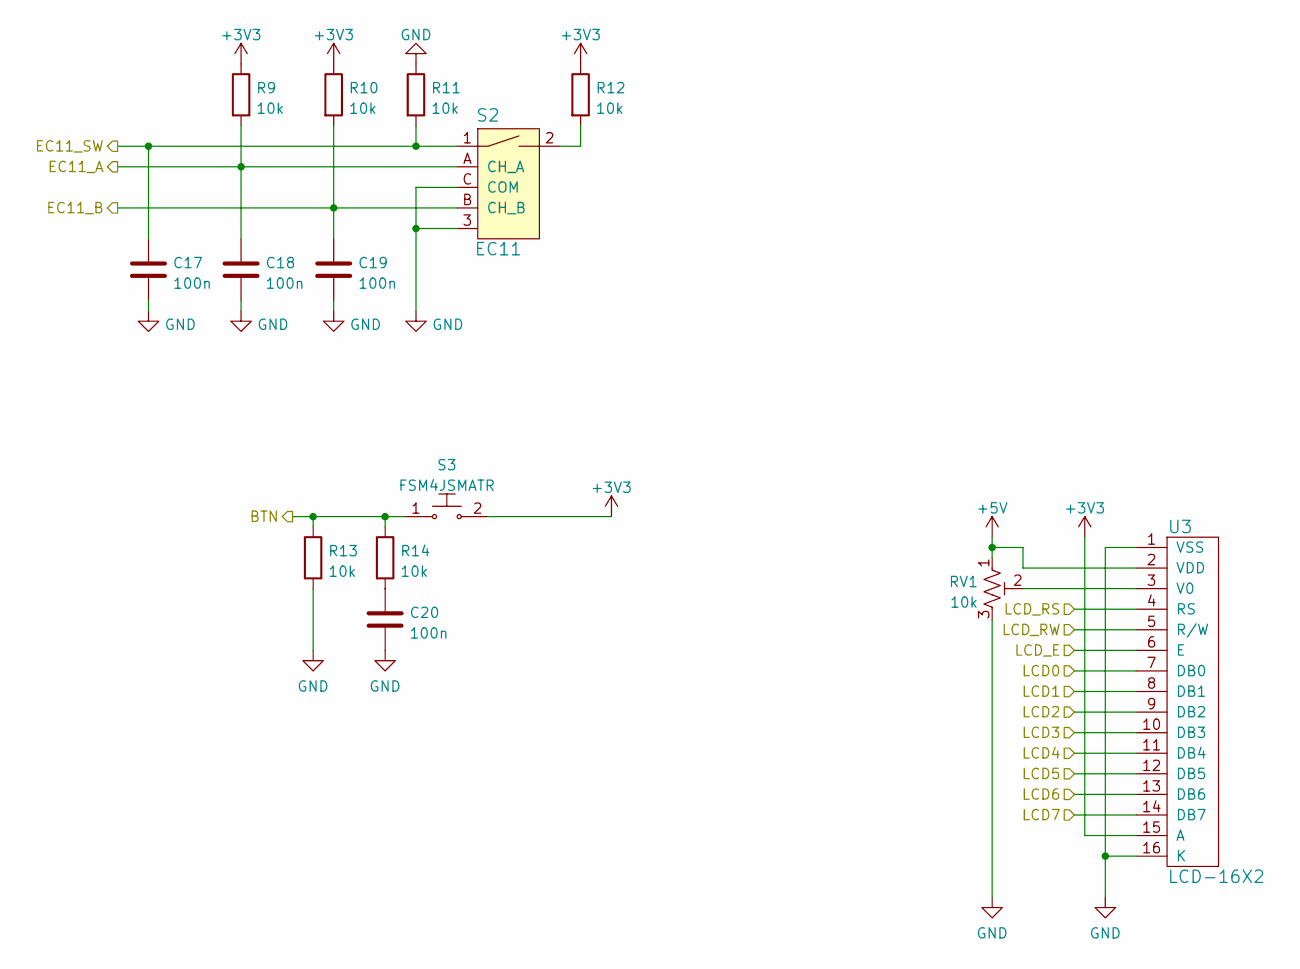
[picture p16: schematic UserInterface.kicad_sch]

Parts:
C17, C18, C19, C20: 100n; C_0805_2012Metric_Pad1.18x1.45mm_HandSolder
R9, R10, R11, R12, R13, R14: 10k; R_0805_2012Metric_Pad1.20x1.40mm_HandSolder
RV1: 10k; Potentiometer_Bourns_3296X_Horizontal
S2: EC11; EC11E; MPN PEC11R-4215F-S0024; Digi-Key_PN PEC11R-4215F-S0024-ND
S3: FSM4JSMATR; SW_Push_1P1T_NO_6x6mm_H9.5mm; MPN FSM4JSMATR
U3: LCD-16X2; WC1602A

Connections:
+3V3: R9.1, R10.1, R12.1, S3.2, U3.15 (A); also elsewhere on the board
+5V: RV1.1, U3.2 (VDD); also elsewhere on the board
/BTN: R13.1, R14.1, S3.1; also elsewhere on the board
/EC11_A: C18.1, R9.2, S2.A (CH_A); also elsewhere on the board
/EC11_B: C19.1, R10.2, S2.B (CH_B); also elsewhere on the board
/EC11_SW: C17.1, R11.2, S2.1; also elsewhere on the board
/LCD0: U3.7 (DB0); also elsewhere on the board
/LCD1: U3.8 (DB1); also elsewhere on the board
/LCD2: U3.9 (DB2); also elsewhere on the board
/LCD3: U3.10 (DB3); also elsewhere on the board
/LCD4: U3.11 (DB4); also elsewhere on the board
/LCD5: U3.12 (DB5); also elsewhere on the board
/LCD6: U3.13 (DB6); also elsewhere on the board
/LCD7: U3.14 (DB7); also elsewhere on the board
/LCD_E: U3.5 (R/W); also elsewhere on the board
/LCD_RS: U3.6 (E); also elsewhere on the board
/LCD_RW: U3.4 (RS); also elsewhere on the board
GND: C17.2, C18.2, C19.2, C20.2, R11.1, R13.2, RV1.3, S2.3, S2.C (COM), U3.1 (VSS), U3.16 (K); also elsewhere on the board
unnamed: C20.1, R14.2
unnamed: R12.2, S2.2
unnamed: RV1.2, U3.3 (V0)

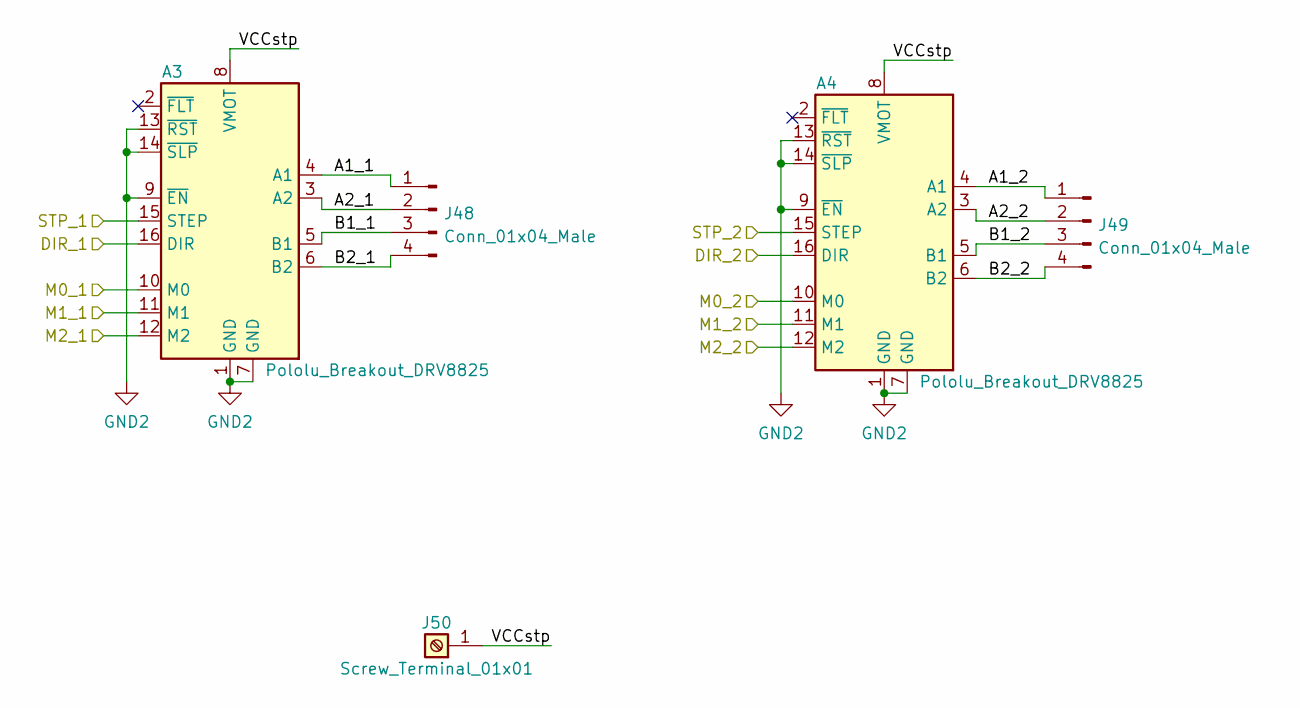
[picture p17: schematic StepperMotorExt.kicad_sch]

Parts:
A3, A4: Pololu_Breakout_DRV8825; Pololu_Breakout-16_15.2x20.3mm
J48, J49: Conn_01x04_Male; PinHeader_1x04_P2.54mm_Vertical
J50: Screw_Terminal_01x01; ScrewTerminal_1x01_5x7mm

Connections:
/Rover Extension/IO0_0: A3.15 (STEP); also elsewhere on the board
/Rover Extension/IO0_1: A3.16 (DIR); also elsewhere on the board
/Rover Extension/IO0_2: A3.10 (M0); also elsewhere on the board
/Rover Extension/IO0_3: A3.11 (M1); also elsewhere on the board
/Rover Extension/IO0_4: A3.12 (M2); also elsewhere on the board
/Rover Extension/IO1_0: A4.15 (STEP); also elsewhere on the board
/Rover Extension/IO1_1: A4.16 (DIR); also elsewhere on the board
/Rover Extension/IO1_2: A4.10 (M0); also elsewhere on the board
/Rover Extension/IO1_3: A4.11 (M1); also elsewhere on the board
/Rover Extension/IO1_4: A4.12 (M2); also elsewhere on the board
/Rover Extension/Stepper Motor Ext./A1_1: A3.4 (A1), J48.1
/Rover Extension/Stepper Motor Ext./A1_2: A4.4 (A1), J49.1
/Rover Extension/Stepper Motor Ext./A2_1: A3.3 (A2), J48.2
/Rover Extension/Stepper Motor Ext./A2_2: A4.3 (A2), J49.2
/Rover Extension/Stepper Motor Ext./B1_1: A3.5 (B1), J48.3
/Rover Extension/Stepper Motor Ext./B1_2: A4.5 (B1), J49.3
/Rover Extension/Stepper Motor Ext./B2_1: A3.6 (B2), J48.4
/Rover Extension/Stepper Motor Ext./B2_2: A4.6 (B2), J49.4
/Rover Extension/Stepper Motor Ext./VCCstp: A3.8 (VMOT), A4.8 (VMOT), J50.1
GND2: A3.1 (GND), A3.7 (GND), A3.9 (~EN), A3.13 (~RST), A3.14 (~SLP), A4.1 (GND), A4.7 (GND), A4.9 (~EN), A4.13 (~RST), A4.14 (~SLP); also elsewhere on the board

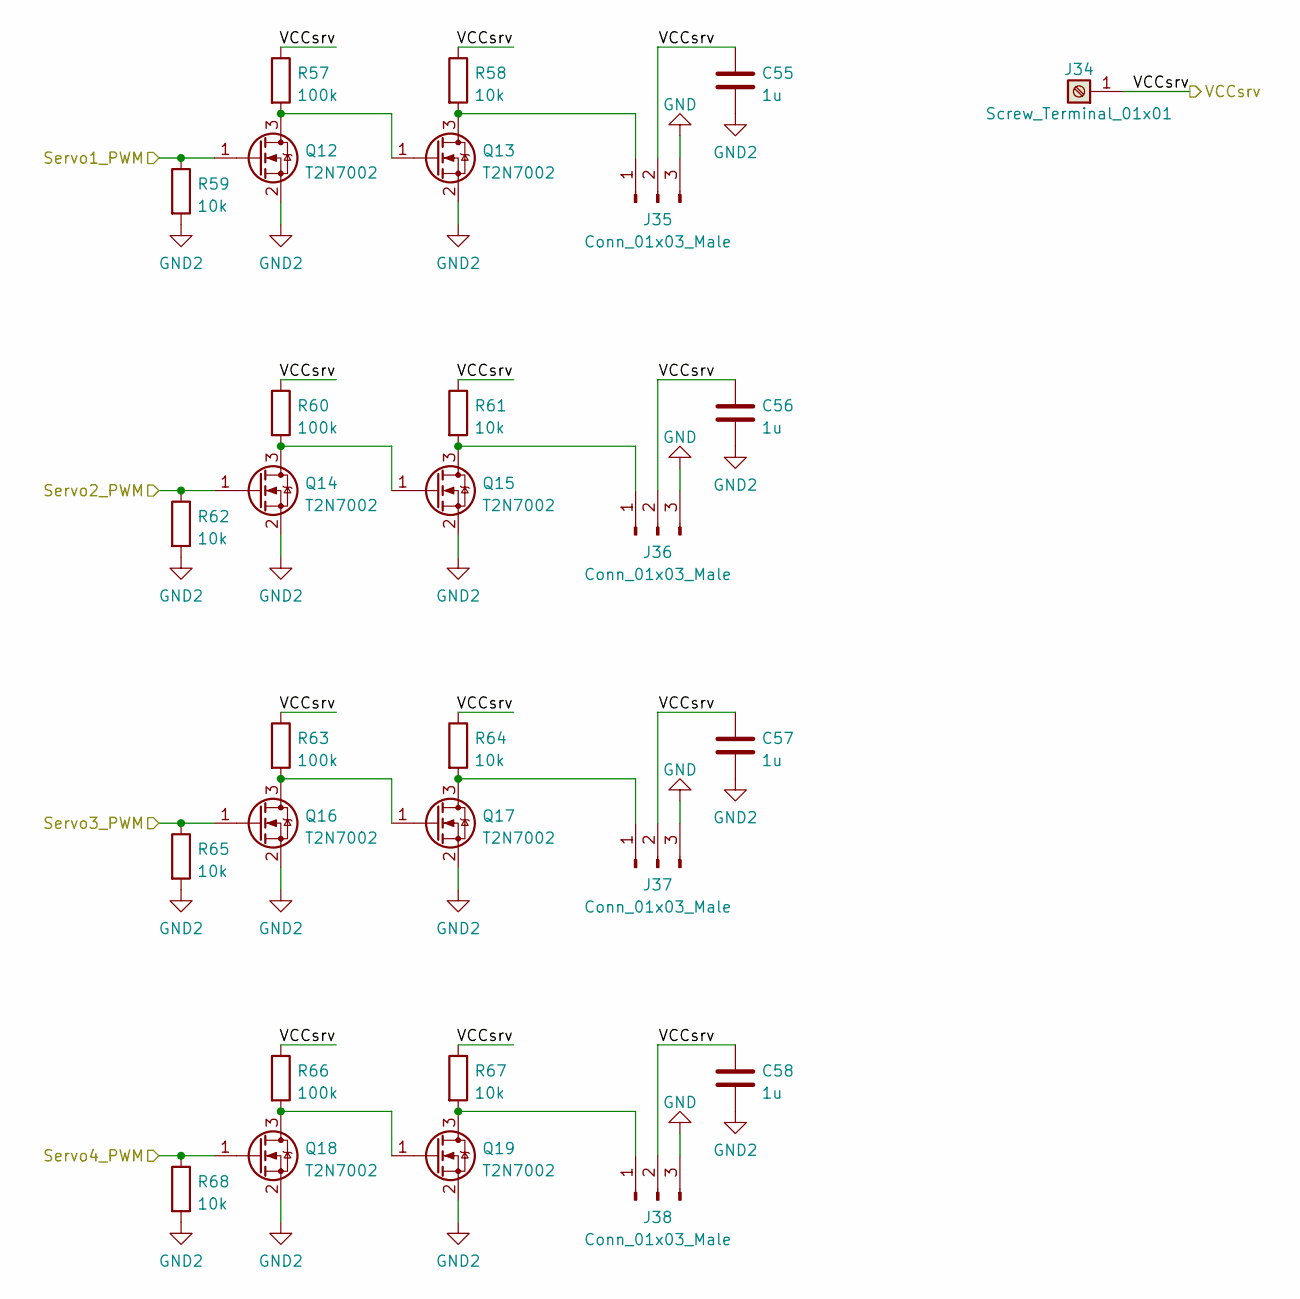
[picture p18: schematic ServoMotorExt.kicad_sch]

Parts:
C55, C56, C57, C58: 1u; C_0805_2012Metric_Pad1.18x1.45mm_HandSolder
J34: Screw_Terminal_01x01; ScrewTerminal_1x01_5x7mm
J35, J36, J37, J38: Conn_01x03_Male; PinHeader_1x03_P2.54mm_Vertical
Q12, Q13, Q14, Q15, Q16, Q17, Q18, Q19: T2N7002; SOT-23
R57, R60, R63, R66: 100k; R_0805_2012Metric_Pad1.20x1.40mm_HandSolder
R58, R59, R61, R62, R64, R65, R67, R68: 10k; R_0805_2012Metric_Pad1.20x1.40mm_HandSolder

Connections:
/Rover Extension/PWM8: Q12.1 (G), R59.1; also elsewhere on the board
/Rover Extension/PWM9: Q14.1 (G), R62.1; also elsewhere on the board
/Rover Extension/PWM10: Q16.1 (G), R65.1; also elsewhere on the board
/Rover Extension/PWM11: Q18.1 (G), R68.1; also elsewhere on the board
/Rover Extension/VCCsrv: C55.1, C56.1, C57.1, C58.1, J34.1, J35.2, J36.2, J37.2, J38.2, R57.1, R58.1, R60.1, R61.1, R63.1, R64.1, R66.1, R67.1; also elsewhere on the board
GND: J35.3, J36.3, J37.3, J38.3; also elsewhere on the board
GND2: C55.2, C56.2, C57.2, C58.2, Q12.2 (S), Q13.2 (S), Q14.2 (S), Q15.2 (S), Q16.2 (S), Q17.2 (S), Q18.2 (S), Q19.2 (S), R59.2, R62.2, R65.2, R68.2; also elsewhere on the board
unnamed: J35.1, Q13.3 (D), R58.2
unnamed: J36.1, Q15.3 (D), R61.2
unnamed: J37.1, Q17.3 (D), R64.2
unnamed: J38.1, Q19.3 (D), R67.2
unnamed: Q12.3 (D), Q13.1 (G), R57.2
unnamed: Q14.3 (D), Q15.1 (G), R60.2
unnamed: Q16.3 (D), Q17.1 (G), R63.2
unnamed: Q18.3 (D), Q19.1 (G), R66.2
