0x72D0/MASA/Hardware/Kicad_Project/MASA_Rover_1.0/MASA_Rover_1.0.kicad_pcb

## KiCad design Hardware/Kicad_Project/MASA_Rover_1.0/MASA_Rover_1.0.kicad_pcb (continued)

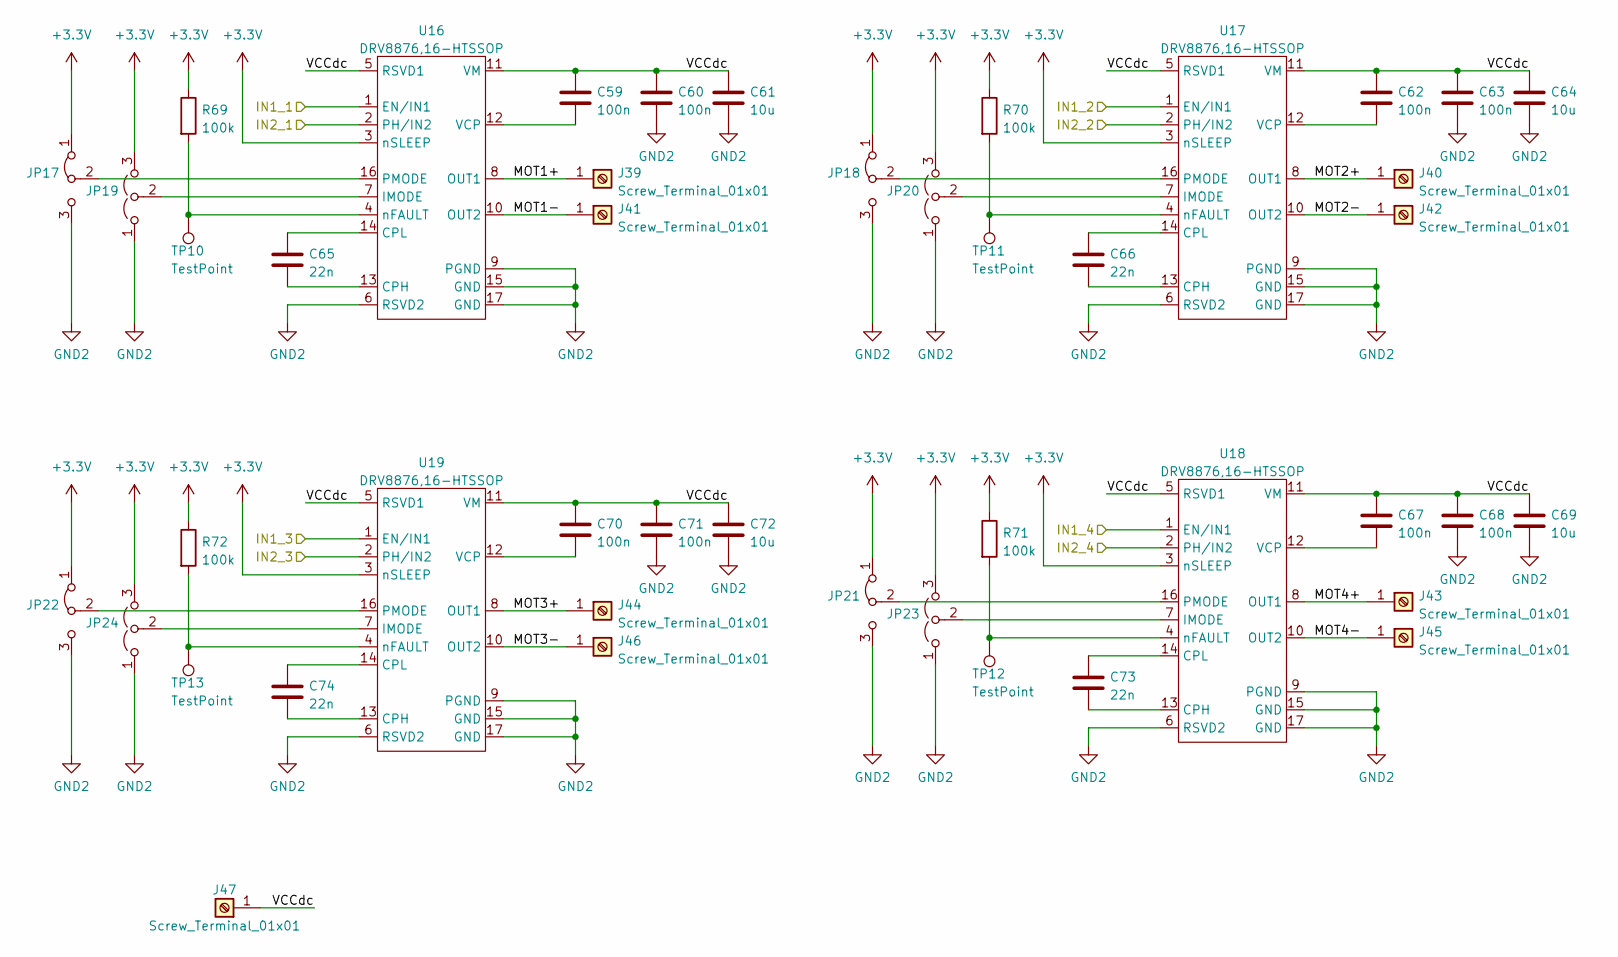
[picture p19: schematic DCmotorExt.kicad_sch]

Parts:
C59, C60, C62, C63, C67, C68, C70, C71: 100n; C_0805_2012Metric_Pad1.18x1.45mm_HandSolder
C61, C64, C69, C72: 10u; C_0805_2012Metric_Pad1.18x1.45mm_HandSolder
C65, C66, C73, C74: 22n; C_0805_2012Metric_Pad1.18x1.45mm_HandSolder
J39, J40, J41, J42, J43, J44, J45, J46, J47: Screw_Terminal_01x01; ScrewTerminal_1x01_5x7mm
JP17, JP18, JP21, JP22: Jumper_3_Bridged12; SolderJumper-3_P1.3mm_Bridged12_Pad1.0x1.5mm
JP19, JP20, JP23, JP24: Jumper_3_Open; SolderJumper-3_P1.3mm_Open_Pad1.0x1.5mm
R69, R70, R71, R72: 100k; R_0805_2012Metric_Pad1.20x1.40mm_HandSolder
TP10, TP11, TP12, TP13: TestPoint; TestPoint_Pad_D2.0mm
U16, U17, U18, U19: DRV8876,16-HTSSOP; HTSSOP-16-1EP_4.4x5mm_P0.65mm_EP3.4x5mm

Connections:
+3.3V: JP17.1 (A), JP18.1 (A), JP19.3 (B), JP20.3 (B), JP21.1 (A), JP22.1 (A), JP23.3 (B), JP24.3 (B), R69.1, R70.1, R71.1, R72.1, U16.3 (nSLEEP), U17.3 (nSLEEP), U18.3 (nSLEEP), U19.3 (nSLEEP); also elsewhere on the board
/Rover Extension/DC Motor Ext./MOT1+: J39.1, U16.8 (OUT1)
/Rover Extension/DC Motor Ext./MOT1-: J41.1, U16.10 (OUT2)
/Rover Extension/DC Motor Ext./MOT2+: J40.1, U17.8 (OUT1)
/Rover Extension/DC Motor Ext./MOT2-: J42.1, U17.10 (OUT2)
/Rover Extension/DC Motor Ext./MOT3+: J44.1, U19.8 (OUT1)
/Rover Extension/DC Motor Ext./MOT3-: J46.1, U19.10 (OUT2)
/Rover Extension/DC Motor Ext./MOT4+: J43.1, U18.8 (OUT1)
/Rover Extension/DC Motor Ext./MOT4-: J45.1, U18.10 (OUT2)
/Rover Extension/DC Motor Ext./VCCdc: C59.1, C60.1, C61.1, C62.1, C63.1, C64.1, C67.1, C68.1, C69.1, C70.1, C71.1, C72.1, J47.1, U16.5 (RSVD1), U16.11 (VM), U17.5 (RSVD1), U17.11 (VM), U18.5 (RSVD1), U18.11 (VM), U19.5 (RSVD1), U19.11 (VM)
/Rover Extension/PWM0: U16.1 (EN/IN1); also elsewhere on the board
/Rover Extension/PWM1: U16.2 (PH/IN2); also elsewhere on the board
/Rover Extension/PWM2: U17.1 (EN/IN1); also elsewhere on the board
/Rover Extension/PWM3: U17.2 (PH/IN2); also elsewhere on the board
/Rover Extension/PWM4: U19.1 (EN/IN1); also elsewhere on the board
/Rover Extension/PWM5: U19.2 (PH/IN2); also elsewhere on the board
/Rover Extension/PWM6: U18.1 (EN/IN1); also elsewhere on the board
/Rover Extension/PWM7: U18.2 (PH/IN2); also elsewhere on the board
GND2: C60.2, C61.2, C63.2, C64.2, C68.2, C69.2, C71.2, C72.2, JP17.3 (B), JP18.3 (B), JP19.1 (A), JP20.1 (A), JP21.3 (B), JP22.3 (B), JP23.1 (A), JP24.1 (A), U16.6 (RSVD2), U16.9 (PGND), U16.15 (GND), U16.17 (GND), U17.6 (RSVD2), U17.9 (PGND), U17.15 (GND), U17.17 (GND), U18.6 (RSVD2), U18.9 (PGND), U18.15 (GND), U18.17 (GND), U19.6 (RSVD2), U19.9 (PGND), U19.15 (GND), U19.17 (GND); also elsewhere on the board
unnamed: C59.2, U16.12 (VCP)
unnamed: C62.2, U17.12 (VCP)
unnamed: C65.1, U16.14 (CPL)
unnamed: C65.2, U16.13 (CPH)
unnamed: C66.1, U17.14 (CPL)
unnamed: C66.2, U17.13 (CPH)
unnamed: C67.2, U18.12 (VCP)
unnamed: C70.2, U19.12 (VCP)
unnamed: C73.1, U18.14 (CPL)
unnamed: C73.2, U18.13 (CPH)
unnamed: C74.1, U19.14 (CPL)
unnamed: C74.2, U19.13 (CPH)
unnamed: JP17.2 (C), U16.16 (PMODE)
unnamed: JP18.2 (C), U17.16 (PMODE)
unnamed: JP19.2 (C), U16.7 (IMODE)
unnamed: JP20.2 (C), U17.7 (IMODE)
unnamed: JP21.2 (C), U18.16 (PMODE)
unnamed: JP22.2 (C), U19.16 (PMODE)
unnamed: JP23.2 (C), U18.7 (IMODE)
unnamed: JP24.2 (C), U19.7 (IMODE)
unnamed: R69.2, TP10.1, U16.4 (nFAULT)
unnamed: R70.2, TP11.1, U17.4 (nFAULT)
unnamed: R71.2, TP12.1, U18.4 (nFAULT)
unnamed: R72.2, TP13.1, U19.4 (nFAULT)

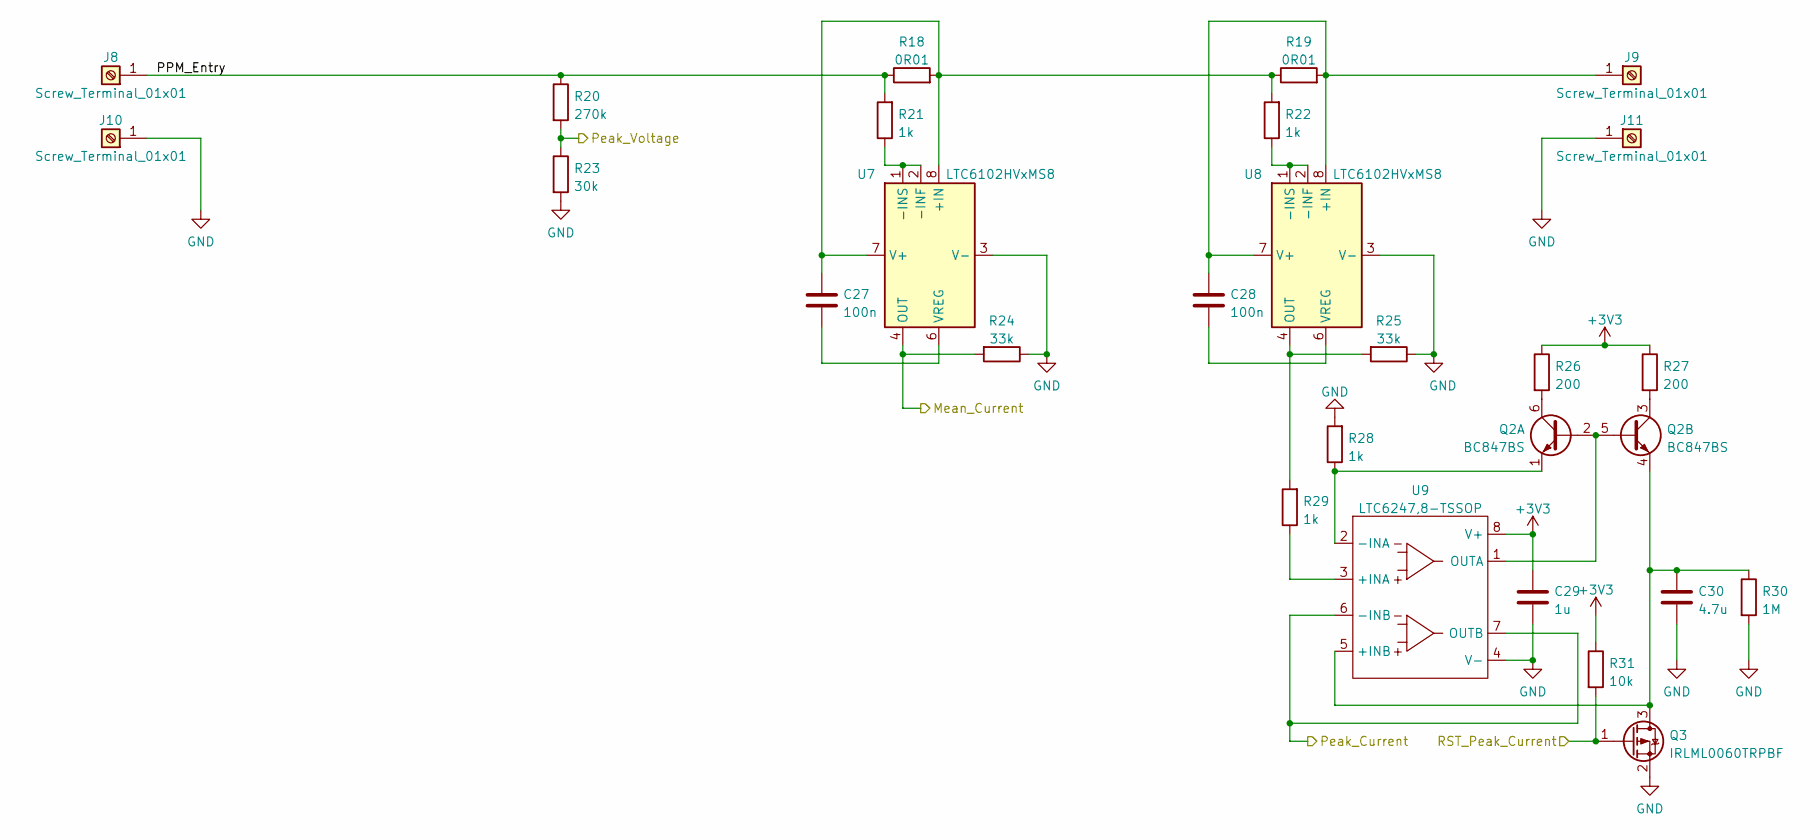
[picture p20: schematic PeakPowerMonitoring.kicad_sch]

Parts:
C27, C28: 100n; C_0805_2012Metric_Pad1.18x1.45mm_HandSolder
C29: 1u; C_0805_2012Metric_Pad1.18x1.45mm_HandSolder
C30: 4.7u; C_0805_2012Metric_Pad1.18x1.45mm_HandSolder
J8, J9, J10, J11: Screw_Terminal_01x01; ScrewTerminal_1x01_5x7mm
Q2: BC847BS; SOT-363_SC-70-6
Q3: IRLML0060TRPBF; SOT-23
R18, R19: 0R01; R_2512_6332Metric_Pad1.40x3.35mm_HandSolder
R20: 270k; R_0805_2012Metric_Pad1.20x1.40mm_HandSolder
R21, R22, R28, R29: 1k; R_0805_2012Metric_Pad1.20x1.40mm_HandSolder
R23: 30k; R_0805_2012Metric_Pad1.20x1.40mm_HandSolder
R24, R25: 33k; R_0805_2012Metric_Pad1.20x1.40mm_HandSolder
R26, R27: 200; R_0805_2012Metric_Pad1.20x1.40mm_HandSolder
R30: 1M; R_0805_2012Metric_Pad1.20x1.40mm_HandSolder
R31: 10k; R_0805_2012Metric_Pad1.20x1.40mm_HandSolder
U7, U8: LTC6102HVxMS8; MSOP-8_3x3mm_P0.65mm
U9: LTC6247,8-TSSOP; TSSOP-8_3x3mm_P0.65mm

Connections:
+3V3: C29.2, R26.1, R27.1, R31.1, U9.8 (V+); also elsewhere on the board
/I2C Expenders/AIN0: R20.2, R23.1; also elsewhere on the board
/I2C Expenders/AIN1: R24.2, U7.4 (OUT); also elsewhere on the board
/I2C Expenders/AIN2: U9.6 (-INB), U9.7 (OUTB); also elsewhere on the board
/I2C Expenders/IO0_5: Q3.1 (G), R31.2; also elsewhere on the board
/I2C Expenders/Peak Power Monitoring/PPM_Entry: J8.1, R18.1, R20.1, R21.2
GND: C29.1, C30.1, J10.1, J11.1, Q3.2 (S), R23.2, R24.1, R25.1, R28.2, R30.2, U7.3 (V-), U7.5 (V-), U8.3 (V-), U8.5 (V-), U9.4 (V-); also elsewhere on the board
unnamed: C27.1, U7.6 (VREG)
unnamed: C27.2, R18.2, R19.1, R22.2, U7.7 (V+), U7.8 (+IN)
unnamed: C28.1, U8.6 (VREG)
unnamed: C28.2, J9.1, R19.2, U8.7 (V+), U8.8 (+IN)
unnamed: C30.2, Q2.4 (E2), Q3.3 (D), R30.1, U9.5 (+INB)
unnamed: Q2.1 (E1), R28.1, U9.2 (-INA)
unnamed: Q2.2 (B1), Q2.5 (B2), U9.1 (OUTA)
unnamed: Q2.3 (C2), R27.2
unnamed: Q2.6 (C1), R26.2
unnamed: R21.1, U7.1 (-INS), U7.2 (-INF)
unnamed: R22.1, U8.1 (-INS), U8.2 (-INF)
unnamed: R25.2, R29.2, U8.4 (OUT)
unnamed: R29.1, U9.3 (+INA)

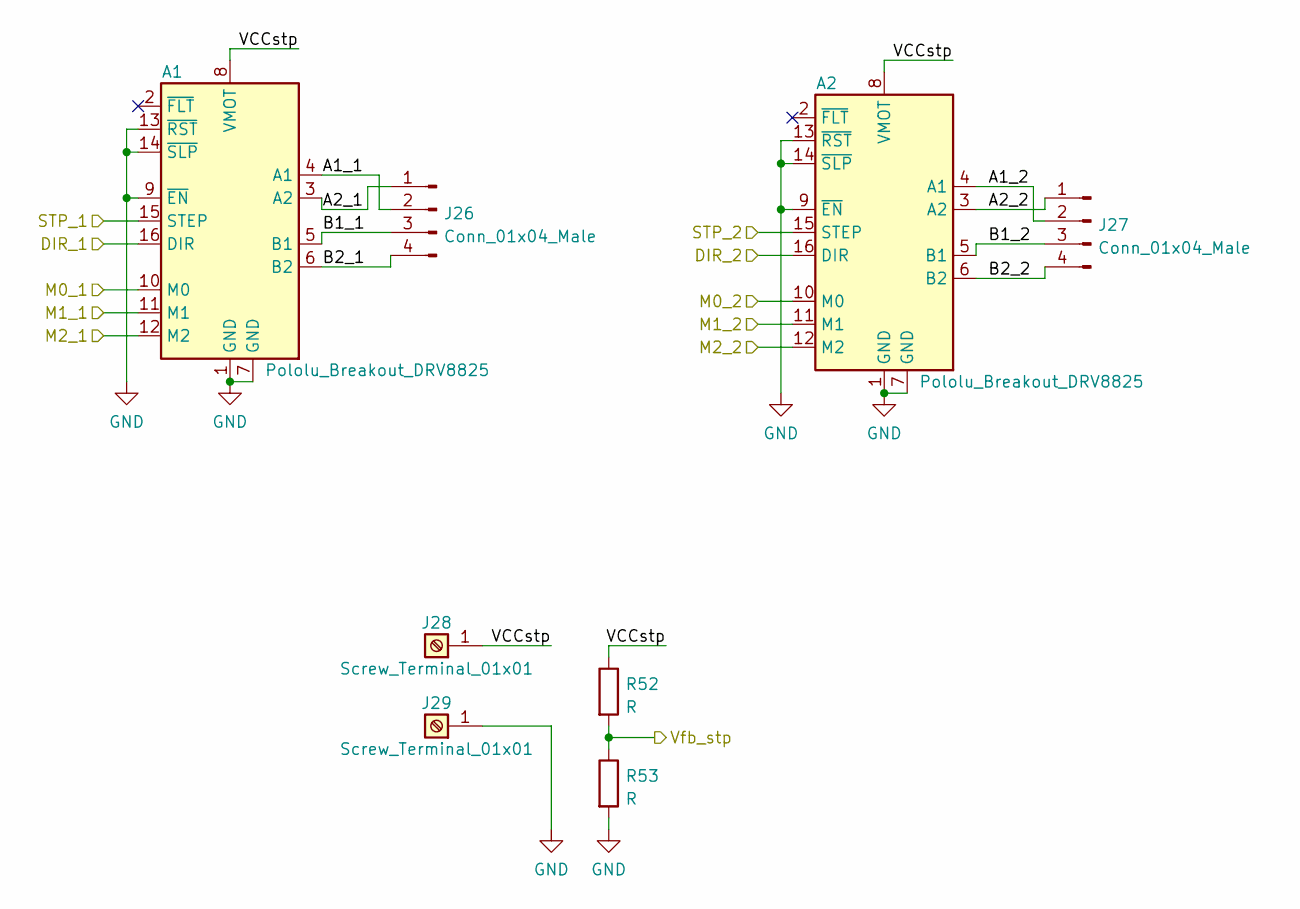
[picture p21: schematic StepperMotor.kicad_sch]

Parts:
A1, A2: Pololu_Breakout_DRV8825; Pololu_Breakout-16_15.2x20.3mm
J26, J27: Conn_01x04_Male; PinHeader_1x04_P2.54mm_Vertical
J28, J29: Screw_Terminal_01x01; ScrewTerminal_1x01_5x7mm
R52, R53: R; R_0805_2012Metric_Pad1.20x1.40mm_HandSolder

Connections:
/I2C Expenders/AIN5: R52.2, R53.1; also elsewhere on the board
/I2C Expenders/IO0_0: A1.15 (STEP); also elsewhere on the board
/I2C Expenders/IO0_1: A1.16 (DIR); also elsewhere on the board
/I2C Expenders/IO0_2: A1.10 (M0); also elsewhere on the board
/I2C Expenders/IO0_3: A1.11 (M1); also elsewhere on the board
/I2C Expenders/IO0_4: A1.12 (M2); also elsewhere on the board
/I2C Expenders/IO1_0: A2.15 (STEP); also elsewhere on the board
/I2C Expenders/IO1_1: A2.16 (DIR); also elsewhere on the board
/I2C Expenders/IO1_2: A2.10 (M0); also elsewhere on the board
/I2C Expenders/IO1_3: A2.11 (M1); also elsewhere on the board
/I2C Expenders/IO1_4: A2.12 (M2); also elsewhere on the board
/I2C Expenders/Stepper Motor/A1_1: A1.4 (A1), J26.2
/I2C Expenders/Stepper Motor/A1_2: A2.4 (A1), J27.2
/I2C Expenders/Stepper Motor/A2_1: A1.3 (A2), J26.1
/I2C Expenders/Stepper Motor/A2_2: A2.3 (A2), J27.1
/I2C Expenders/Stepper Motor/B1_1: A1.5 (B1), J26.3
/I2C Expenders/Stepper Motor/B1_2: A2.5 (B1), J27.3
/I2C Expenders/Stepper Motor/B2_1: A1.6 (B2), J26.4
/I2C Expenders/Stepper Motor/B2_2: A2.6 (B2), J27.4
/I2C Expenders/Stepper Motor/VCCstp: A1.8 (VMOT), A2.8 (VMOT), J28.1, R52.1
GND: A1.1 (GND), A1.7 (GND), A1.9 (~EN), A1.13 (~RST), A1.14 (~SLP), A2.1 (GND), A2.7 (GND), A2.9 (~EN), A2.13 (~RST), A2.14 (~SLP), J29.1, R53.2; also elsewhere on the board

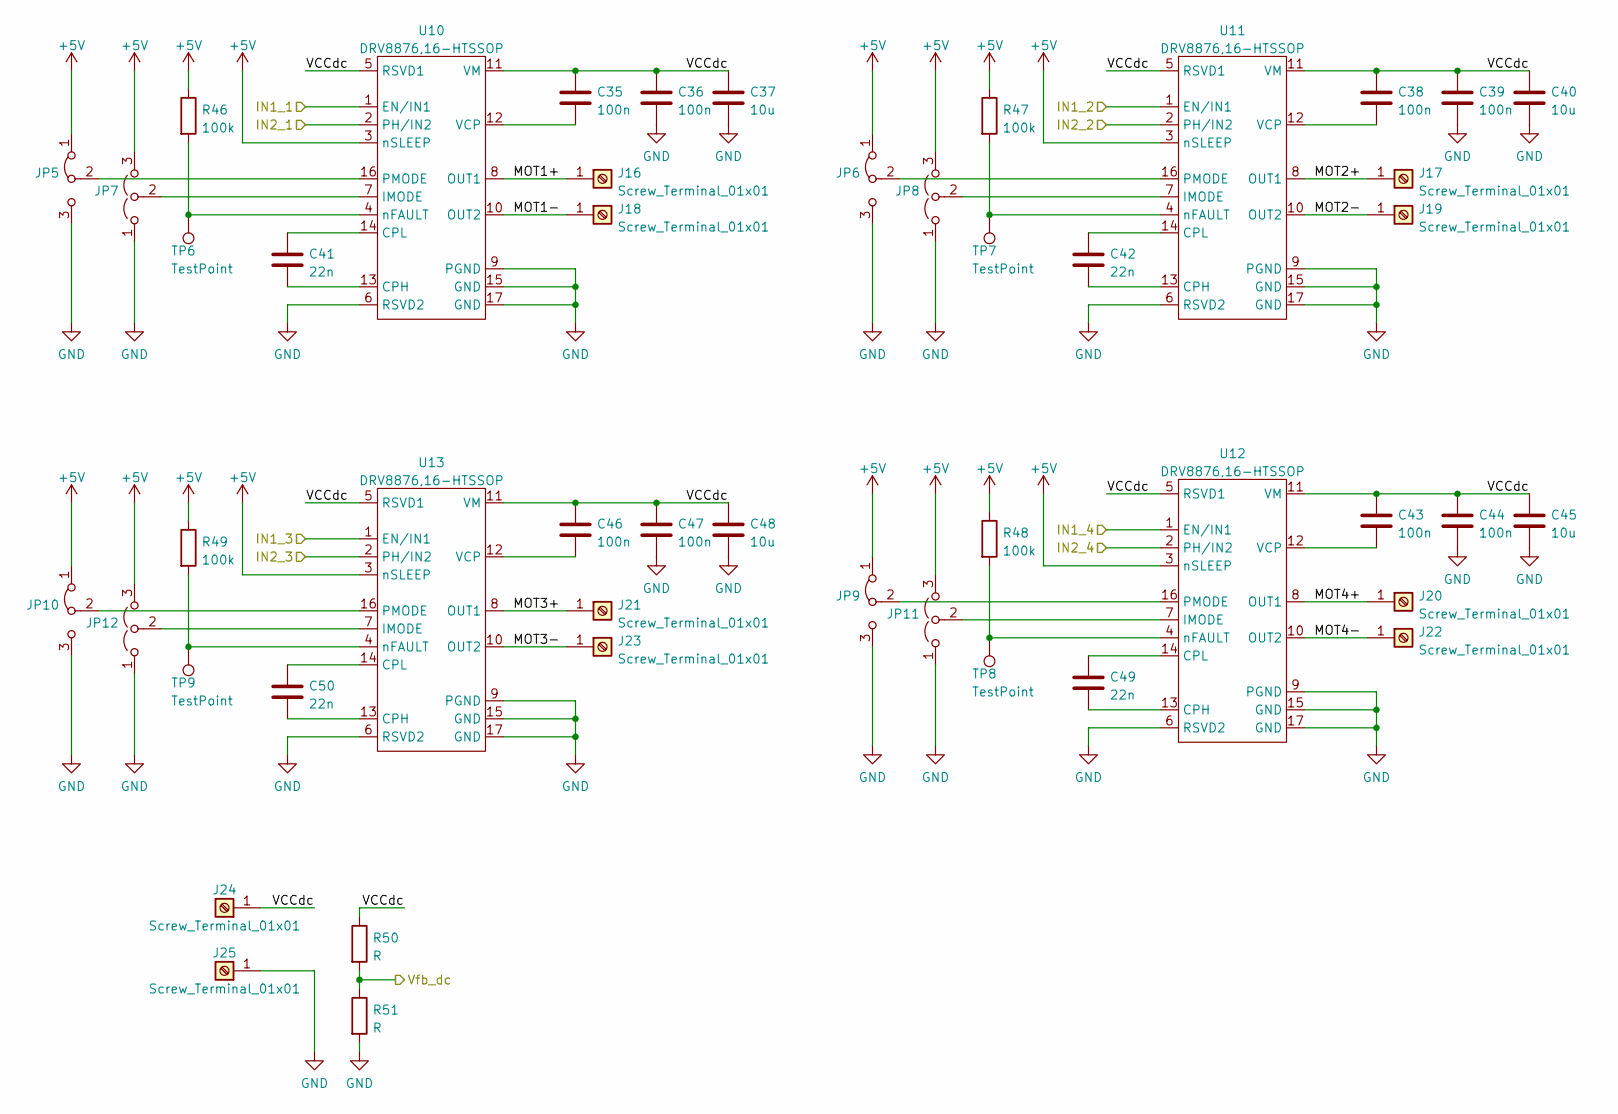
[picture p22: schematic DCmotor.kicad_sch]

Parts:
C35, C36, C38, C39, C43, C44, C46, C47: 100n; C_0805_2012Metric_Pad1.18x1.45mm_HandSolder
C37, C40, C45, C48: 10u; C_0805_2012Metric_Pad1.18x1.45mm_HandSolder
C41, C42, C49, C50: 22n; C_0805_2012Metric_Pad1.18x1.45mm_HandSolder
J16, J17, J18, J19, J20, J21, J22, J23, J24, J25: Screw_Terminal_01x01; ScrewTerminal_1x01_5x7mm
JP5, JP6, JP9, JP10: Jumper_3_Bridged12; SolderJumper-3_P1.3mm_Bridged12_Pad1.0x1.5mm
JP7, JP8, JP11, JP12: Jumper_3_Open; SolderJumper-3_P1.3mm_Open_Pad1.0x1.5mm
R46, R47, R48, R49: 100k; R_0805_2012Metric_Pad1.20x1.40mm_HandSolder
R50, R51: R; R_0805_2012Metric_Pad1.20x1.40mm_HandSolder
TP6, TP7, TP8, TP9: TestPoint; TestPoint_Pad_D2.0mm
U10, U11, U12, U13: DRV8876,16-HTSSOP; HTSSOP-16-1EP_4.4x5mm_P0.65mm_EP3.4x5mm

Connections:
+5V: JP5.1 (A), JP6.1 (A), JP7.3 (B), JP8.3 (B), JP9.1 (A), JP10.1 (A), JP11.3 (B), JP12.3 (B), R46.1, R47.1, R48.1, R49.1, U10.3 (nSLEEP), U11.3 (nSLEEP), U12.3 (nSLEEP), U13.3 (nSLEEP); also elsewhere on the board
/I2C Expenders/AIN4: R50.2, R51.1; also elsewhere on the board
/I2C Expenders/DC Motor/MOT1+: J16.1, U10.8 (OUT1)
/I2C Expenders/DC Motor/MOT1-: J18.1, U10.10 (OUT2)
/I2C Expenders/DC Motor/MOT2+: J17.1, U11.8 (OUT1)
/I2C Expenders/DC Motor/MOT2-: J19.1, U11.10 (OUT2)
/I2C Expenders/DC Motor/MOT3+: J21.1, U13.8 (OUT1)
/I2C Expenders/DC Motor/MOT3-: J23.1, U13.10 (OUT2)
/I2C Expenders/DC Motor/MOT4+: J20.1, U12.8 (OUT1)
/I2C Expenders/DC Motor/MOT4-: J22.1, U12.10 (OUT2)
/I2C Expenders/DC Motor/VCCdc: C35.1, C36.1, C37.1, C38.1, C39.1, C40.1, C43.1, C44.1, C45.1, C46.1, C47.1, C48.1, J24.1, R50.1, U10.5 (RSVD1), U10.11 (VM), U11.5 (RSVD1), U11.11 (VM), U12.5 (RSVD1), U12.11 (VM), U13.5 (RSVD1), U13.11 (VM)
/I2C Expenders/PWM0: U10.1 (EN/IN1); also elsewhere on the board
/I2C Expenders/PWM1: U10.2 (PH/IN2); also elsewhere on the board
/I2C Expenders/PWM2: U11.1 (EN/IN1); also elsewhere on the board
/I2C Expenders/PWM3: U11.2 (PH/IN2); also elsewhere on the board
/I2C Expenders/PWM4: U13.1 (EN/IN1); also elsewhere on the board
/I2C Expenders/PWM5: U13.2 (PH/IN2); also elsewhere on the board
/I2C Expenders/PWM6: U12.1 (EN/IN1); also elsewhere on the board
/I2C Expenders/PWM7: U12.2 (PH/IN2); also elsewhere on the board
GND: C36.2, C37.2, C39.2, C40.2, C44.2, C45.2, C47.2, C48.2, J25.1, JP5.3 (B), JP6.3 (B), JP7.1 (A), JP8.1 (A), JP9.3 (B), JP10.3 (B), JP11.1 (A), JP12.1 (A), R51.2, U10.6 (RSVD2), U10.9 (PGND), U10.15 (GND), U10.17 (GND), U11.6 (RSVD2), U11.9 (PGND), U11.15 (GND), U11.17 (GND), U12.6 (RSVD2), U12.9 (PGND), U12.15 (GND), U12.17 (GND), U13.6 (RSVD2), U13.9 (PGND), U13.15 (GND), U13.17 (GND); also elsewhere on the board
unnamed: C35.2, U10.12 (VCP)
unnamed: C38.2, U11.12 (VCP)
unnamed: C41.1, U10.14 (CPL)
unnamed: C41.2, U10.13 (CPH)
unnamed: C42.1, U11.14 (CPL)
unnamed: C42.2, U11.13 (CPH)
unnamed: C43.2, U12.12 (VCP)
unnamed: C46.2, U13.12 (VCP)
unnamed: C49.1, U12.14 (CPL)
unnamed: C49.2, U12.13 (CPH)
unnamed: C50.1, U13.14 (CPL)
unnamed: C50.2, U13.13 (CPH)
unnamed: JP5.2 (C), U10.16 (PMODE)
unnamed: JP6.2 (C), U11.16 (PMODE)
unnamed: JP7.2 (C), U10.7 (IMODE)
unnamed: JP8.2 (C), U11.7 (IMODE)
unnamed: JP9.2 (C), U12.16 (PMODE)
unnamed: JP10.2 (C), U13.16 (PMODE)
unnamed: JP11.2 (C), U12.7 (IMODE)
unnamed: JP12.2 (C), U13.7 (IMODE)
unnamed: R46.2, TP6.1, U10.4 (nFAULT)
unnamed: R47.2, TP7.1, U11.4 (nFAULT)
unnamed: R48.2, TP8.1, U12.4 (nFAULT)
unnamed: R49.2, TP9.1, U13.4 (nFAULT)

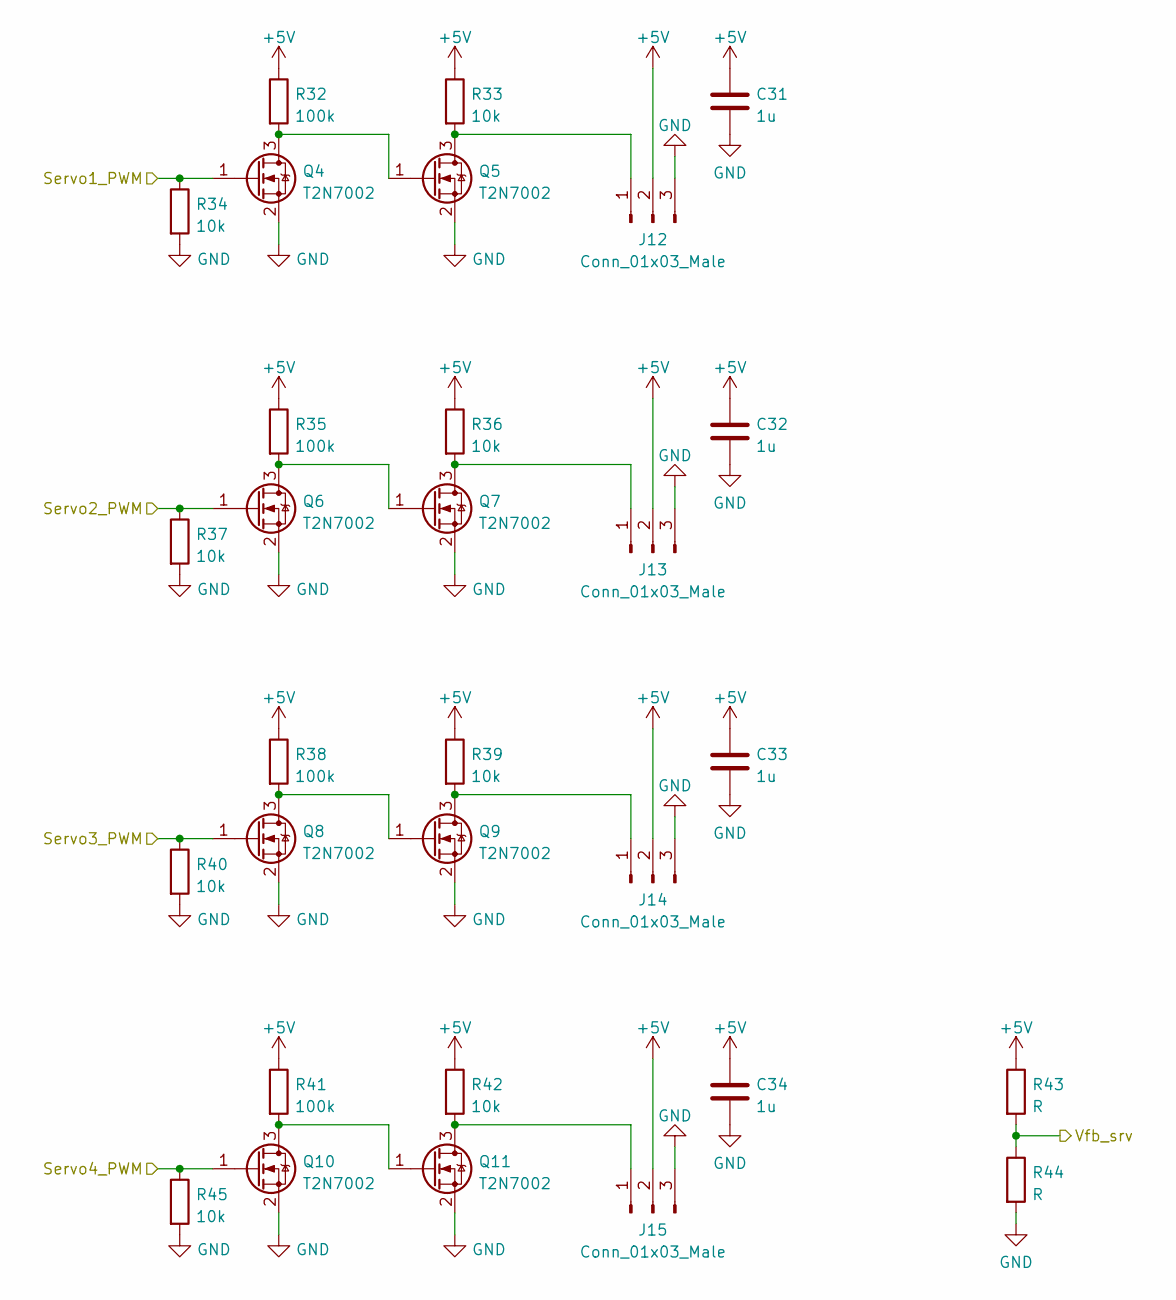
[picture p23: schematic ServoMotor.kicad_sch]

Parts:
C31, C32, C33, C34: 1u; C_0805_2012Metric_Pad1.18x1.45mm_HandSolder
J12, J13, J14, J15: Conn_01x03_Male; PinHeader_1x03_P2.54mm_Vertical
Q4, Q5, Q6, Q7, Q8, Q9, Q10, Q11: T2N7002; SOT-23
R32, R35, R38, R41: 100k; R_0805_2012Metric_Pad1.20x1.40mm_HandSolder
R33, R34, R36, R37, R39, R40, R42, R45: 10k; R_0805_2012Metric_Pad1.20x1.40mm_HandSolder
R43, R44: R; R_0805_2012Metric_Pad1.20x1.40mm_HandSolder

Connections:
+5V: C31.1, C32.1, C33.1, C34.1, J12.2, J13.2, J14.2, J15.2, R32.1, R33.1, R35.1, R36.1, R38.1, R39.1, R41.1, R42.1, R43.1; also elsewhere on the board
/I2C Expenders/AIN3: R43.2, R44.1; also elsewhere on the board
/I2C Expenders/PWM8: Q4.1 (G), R34.1; also elsewhere on the board
/I2C Expenders/PWM9: Q6.1 (G), R37.1; also elsewhere on the board
/I2C Expenders/PWM10: Q8.1 (G), R40.1; also elsewhere on the board
/I2C Expenders/PWM11: Q10.1 (G), R45.1; also elsewhere on the board
GND: C31.2, C32.2, C33.2, C34.2, J12.3, J13.3, J14.3, J15.3, Q4.2 (S), Q5.2 (S), Q6.2 (S), Q7.2 (S), Q8.2 (S), Q9.2 (S), Q10.2 (S), Q11.2 (S), R34.2, R37.2, R40.2, R44.2, R45.2; also elsewhere on the board
unnamed: J12.1, Q5.3 (D), R33.2
unnamed: J13.1, Q7.3 (D), R36.2
unnamed: J14.1, Q9.3 (D), R39.2
unnamed: J15.1, Q11.3 (D), R42.2
unnamed: Q4.3 (D), Q5.1 (G), R32.2
unnamed: Q6.3 (D), Q7.1 (G), R35.2
unnamed: Q8.3 (D), Q9.1 (G), R38.2
unnamed: Q10.3 (D), Q11.1 (G), R41.2

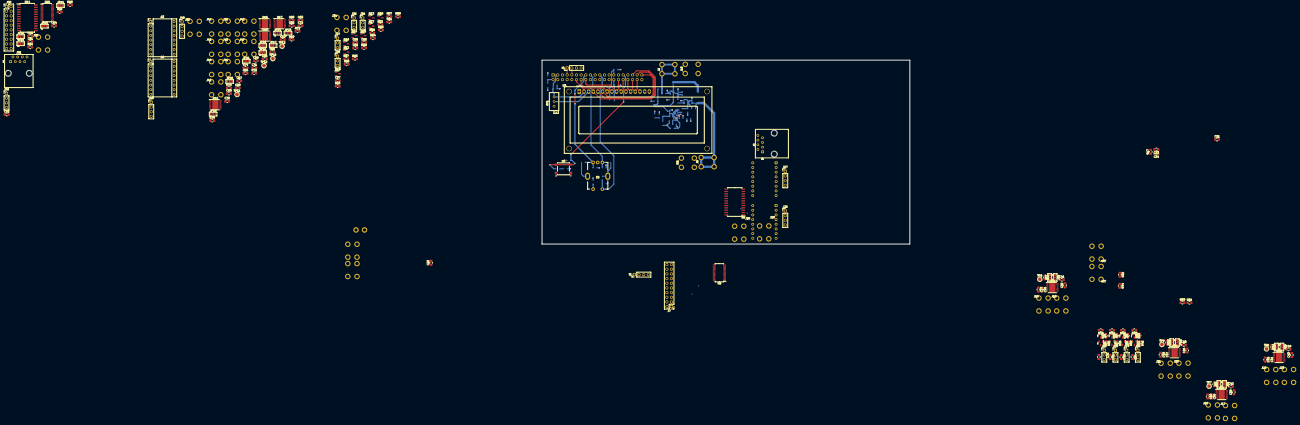
[picture p24: board MASA_Rover_1.0.kicad_pcb from above]

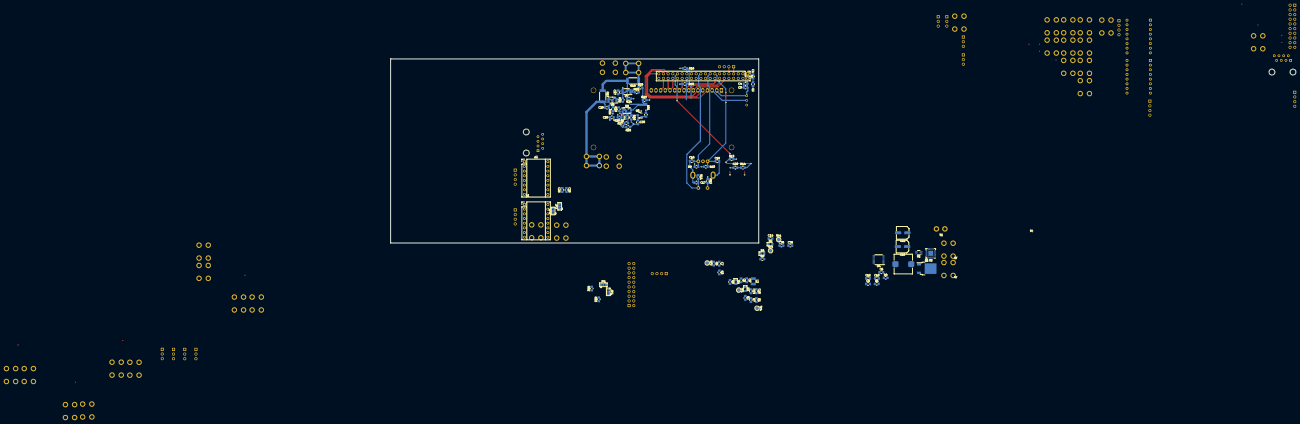
[picture p25: board MASA_Rover_1.0.kicad_pcb from below]

Board: 4 copper layers, 200.0 x 100.0 mm, 288 parts (91 on the bottom side), 238 nets.
