0x72D0/MASA/Software/Rover/Model/Motor.py

from typing import Mapping
from Model.Action import Action
from Model.Action import ActionType

from enum import Enum

class MotorState(Enum):
    """Enumeration of state for the servo motor"""
    INIT = 0
    TOGGLE_ON = 1
    RELEASE_ON = 2

class Motor:
    """Class that define one servo motor component"""
    def __init__(self) -> None:
        self._currentSpeed = 0
        self._currentState = MotorState.INIT
    
    def update(self, action: Action) -> None:
        if self._currentState == MotorState.INIT:
            if action.get_actionType() == ActionType.TOGGLE:
                print("motor Toggle ON")
                self._currentSpeed = action.get_actionArguments()[0]
                self._currentState = MotorState.TOGGLE_ON
            
            elif action.get_actionType() == ActionType.RELEASE_ON:
                print("motor Release ON")
                self._currentSpeed = action.get_actionArguments()[0]
                self._currentState = MotorState.RELEASE_ON
            
            elif action.get_actionType() == ActionType.STEP:
                print("motor STEP")
                self._currentSpeed += action.get_actionArguments()[0]

            elif action.get_actionType() == ActionType.ANALOG:
                print("motor ANALOG")
                args = action.get_actionArguments()
                # first argument is the type of analog control
                if args[0] == 0:
                    if args[2] >= 0:
                        self._currentSpeed = (args[2]/255)*args[1]
                    else:
                        self._currentSpeed = 0
            
        elif self._currentState == MotorState.TOGGLE_ON:
            if action.get_actionType() == ActionType.TOGGLE:
                print("motor Toggle OFF")
                self._currentSpeed = 0
                self._currentState = MotorState.INIT
        
        elif self._currentState == MotorState.RELEASE_ON:
            if action.get_actionType() == ActionType.RELEASE_OFF:
                print("motor Release OFF")
                self._currentSpeed = 0
                self._currentState = MotorState.INIT
    
    def getSpeed(self) -> int:
        return self._currentSpeed
