0x72D0/MASA/Software/Rover/Model/Model.py

from Model.Action import Action
from Model.Component import Component
from Model.Component import ComponentType
from Model.Profile import Profile
from Model.ProfileDatabase import ProfileDatabase
from Model.ServoMotor import ServoMotor
from Model.StepperMotor import StepperMotor
from Model.Motor import Motor

class Model:
    """Singleton that define all the model."""
    def __init__(self) -> None:
        self.SERVO_NUM = 4
        self.STEPPER_NUM = 2
        self.MOTOR_NUM = 4

        self._profileDatabase = ProfileDatabase()
        self._currentProfileName = ""

        self._servos = [ServoMotor()] * self.MOTOR_NUM
        self._motors = [Motor()] * self.SERVO_NUM
        self._stepper = [StepperMotor()] * self.STEPPER_NUM
    
    def cleanup(self) -> None:
        if self._profileDatabase.get_profile(self._currentProfileName) != None:
            self._profileDatabase.get_profile(self._currentProfileName).cleanup()
    
    def get_servoNum(self) -> int:
        return self.SERVO_NUM
    
    def get_stepperNum(self) -> int:
        return self.STEPPER_NUM
    
    def get_motorNum(self) -> int:
        return self.MOTOR_NUM
    
    def get_servoComponent(self, position: int) -> ServoMotor:
        return self._servos[position]
    
    def get_stepperComponent(self, position: int) -> StepperMotor:
        return self._stepper[position]
    
    def get_motorComponent(self, position: int) -> Motor:
        return self._motors[position]

    def get_servosAngle(self) -> list[int]:
        tempList = list[int]()
        for servo in self._servos:
            tempList.append(servo.getAngle())
        return tempList
    
    def get_motorsSpeed(self) -> list[int]:
        tempList = list[int]()
        for motor in self._motors:
            tempList.append(motor.getSpeed())
        return tempList
    
    def get_stepperStep(self) -> list[int]:
        tempList = list[int]()
        for stepper in self._stepper:
            tempList.append(stepper.getStep())
        return tempList
    
    def startNewProfile(self, name: str) -> None:
        self._profileDatabase.newProfile(name)

    def mapDigitalInputToProfile(self, action: Action, component:Component) -> bool:
        profile = self._profileDatabase.get_profile(self._currentProfileName)
        
        if profile is None:
            return False
        
        return profile.mapDigitalInputToProfile(action, component)
    
    def mapAnalogicInputToProfile(self, action: Action, component:Component) -> bool:
        profile = self._profileDatabase.get_profile(self._currentProfileName)

        if profile is None:
            return False
        
        return profile.mapAnalogicInputToProfile(action, component)
    
    def setCurrentProfileName(self, name: str) -> None:
        self._currentProfileName = name
    
    def deleteProfileName(self, name: str) -> None:
        self._profileDatabase.deleteProfile(name)
    
    def get_profileNameList(self) -> list[str]:
        return self._profileDatabase.get_profilesName()
    
    def saveProfiles(self) -> None:
        self._profileDatabase.save_profiles()
    
    def update(self) -> None:
        profile = self._profileDatabase.get_profile(self._currentProfileName)
        if profile is not None:
            profile.update()

            while not profile.actionIsEmpty():
                mapping = profile.get_nextMapping()
                
                if mapping.get_componentType() == ComponentType.SERVO_MOTOR:
                    self._servos[mapping.get_componentPosition()].update(mapping.get_action())
                
                elif mapping.get_componentType() == ComponentType.DC_MOTOR:
                    self._motors[mapping.get_componentPosition()].update(mapping.get_action())
                
                elif mapping.get_componentType() == ComponentType.STEPPER:
                    self._stepper[mapping.get_componentPosition()].update(mapping.get_action())
