0x72D0/MASA/Menu.h

#pragma once

#include <LiquidCrystal_I2C.h>

#include "Model.h"

class Menu
{
    public:
        Menu(): lcd(0x27, 20, 4) 
        {
            currentlySelectedRow = 0;
        }

        void init(Model* model)
        {
            lcd.init();
            lcd.backlight();
            lcd.createChar(0, selectArrow);

            this->model = model;
        }

        void handleMenu()
        {
            updateScreen();

            switch (model->getCurrentGraphicPage())
            {
                case Model::GraphicPage::MAIN:
                    printMainMenu();
                    break;
                
                case Model::GraphicPage::MONITOR:
                    printMonitor();
                    break;
                
                case Model::GraphicPage::CONTROLLER:
                    printController();
                    break;
                
                default:
                    break;
            }
        }

        void updateScreen()
        {
            if(currentlySelectedRow != model->getCursorPosition())
            {
                lcd.clear();
                currentlySelectedRow = model->getCursorPosition();
            }
        }

        void printMainMenu()
        {
            lcd.setCursor(1, 0);
            lcd.print("Monitor >");
            lcd.setCursor(1,1);
            lcd.print("Controller >");

            lcd.setCursor(0,currentlySelectedRow);
            lcd.write(byte(0));
        }

        void printMonitor()
        {

        }

        void printController()
        {
            
        }

    private:

        byte selectArrow[8] = {B00000, B00100, B00110, B11111, B11111, B00110, B00100, B00000};

        LiquidCrystal_I2C lcd;
        Model* model;

        int currentlySelectedRow;
};
