0x72D0/MASA/Software/Rover/Model/Menu/ProfileMenuContext.py

from Model.Menu.AddProfileNameMenuContext import AddProfileNameMenuContext
from Model.Menu.MenuStack import MenuStack
from Model.Menu.MenuType import MenuType
from Model.Menu.ProfileConfigContext import ProfileConfigContext
from Model.Menu.ProfileOptionMenuContext import ProfileOptionMenuContext
from Model.Model import Model
from Model.Menu.IMenuContext import IMenuContext
from Controller.ButtonController import ButtonController
from Controller.RotaryEncoderController import RotaryEncoderController


class ProfileMenuContext(IMenuContext):
    """Menu that decide what profile the user gonna use."""
    def __init__(self, model: Model) -> None:
        self._profile_list = [u'New profile']
        super().__init__(model)
    
    def get_menuStructure(self) -> tuple:
        return MenuType.LIST, self._profile_list

    def update(self, encoderHandle: RotaryEncoderController, buttonHandle: ButtonController, menuStack: MenuStack)-> None:
        self._handleListMenuIndex(encoderHandle, len(self._model.get_profileNameList()))

        self._profile_list = [u'New profile']
        for profile in self._model.get_profileNameList():
            self._profile_list.append(profile)
        
        # manage the menu Accept button
        acceptButtonState = buttonHandle.get_rotaryEncoderButtonState()
        backButtonState = buttonHandle.get_backButtonState()

        if acceptButtonState == 1:
            if self._currentIndex == 0:
                menuStack.add(AddProfileNameMenuContext(self._model))
            else:
                menuStack.add(ProfileOptionMenuContext(self._model, self._profile_list[self._currentIndex]))
        
        if backButtonState == 1:
            menuStack.pop()
