0x72D0/MASA/(commit log)

2022-10-05 making the servo work
2022-10-05 adding rotary encoder repo (temporary)
2022-10-11 rework the lcd list handling
    [IMenuContext.py, LcdView.py, Menu.py, MenuType.py]
2022-10-11 fix button bug
2022-11-05 add hardware
    [DCmotor.kicad_sch, DCmotorExt.kicad_sch, I2CExpender.kicad_sch, MASA_Rover_1.0.kicad_pcb, MASA_Rover_1.0.kicad_sch, PeakPowerMonitoring.kicad_sch, PowerSupply.kicad_sch, RoverExtension.kicad_sch]
2022-11-12 add temporary dummy motor
2022-11-28 continu motor implementation
2022-12-03 officially add stepper and DC
2022-12-14 update hardware
    [DCmotor.kicad_sch, DCmotorExt.kicad_sch, I2CExpender.kicad_sch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]
